theBrutzler/ILI9341_DMG_01/README.md

# ILI9341_DMG_01
 GESP Mainboard for ORIGINAL GAMEBOY
