theBrutzler/ILI9341_DMG_01/ILI9341_ESP32/production/bom.csv

Designator | Footprint | Quantity | Value | LCSC Part #
CN1 | AUDIO-TH_PJ-3043-B | 1 | PJ-3043-B
SM3 | Symbol_kurzschlussblog | 1 | SYM_Arrow45_Tiny
