theBrutzler/ILI9341_DMG_01/ILI9341_ESP32/ILI9341_ESP32.pdf

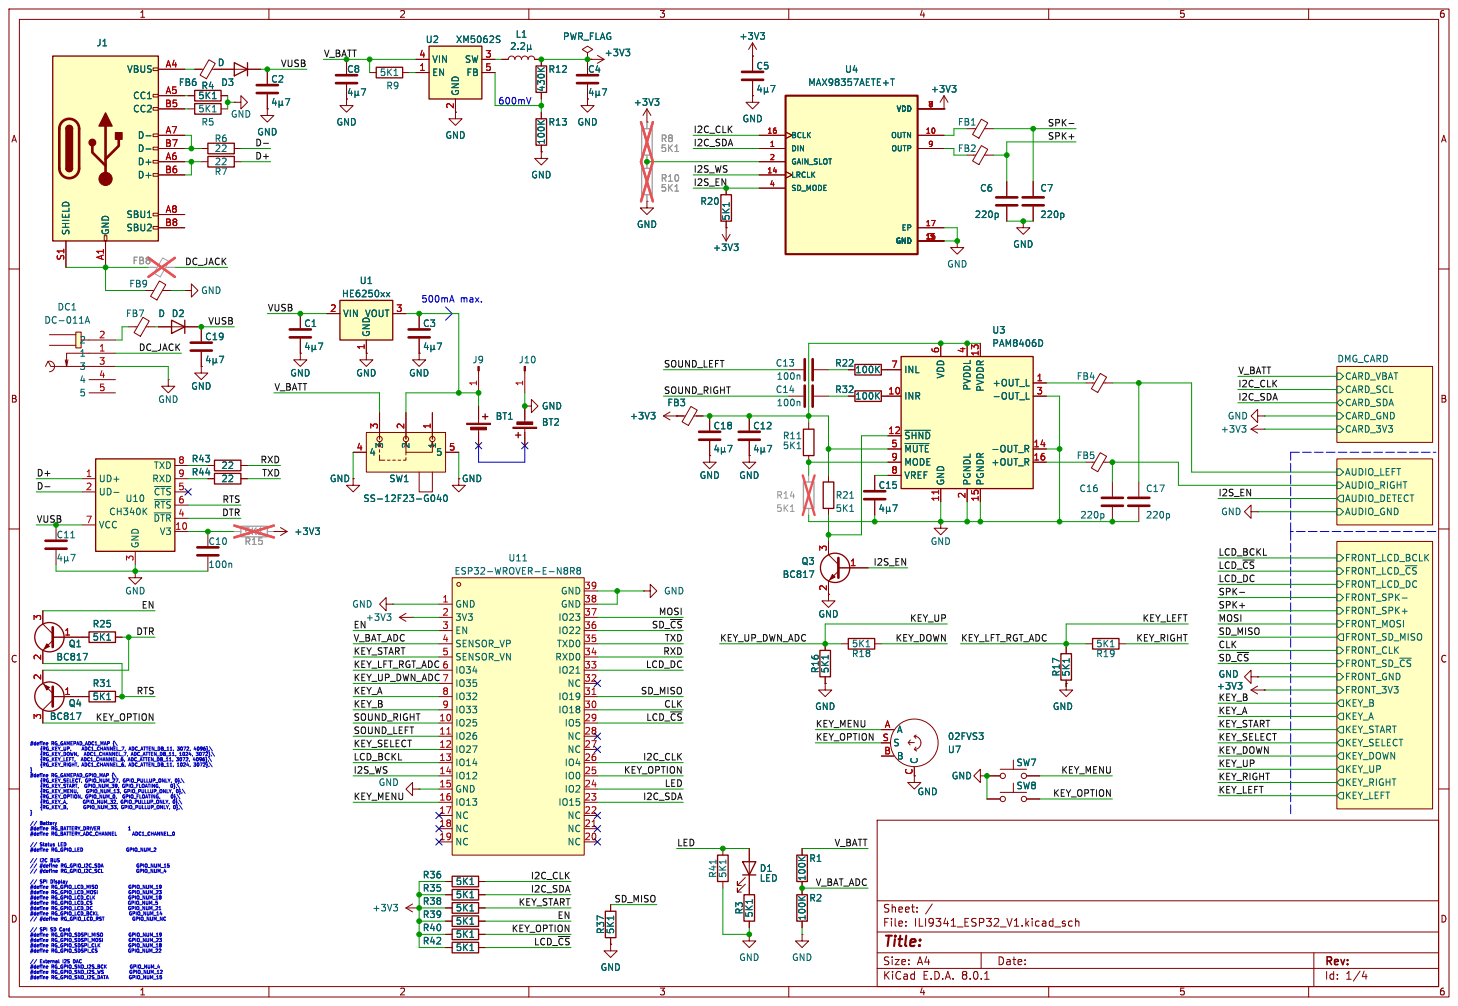
[picture p1: page 1]

2 SW 3 VIN 4 FB 5 GND
220p GND

3 ~{DTR}4 ~{CTS}5 ~{RTS}6 VCC 7 TXD 8 RXD 9 U10 CH340K C19

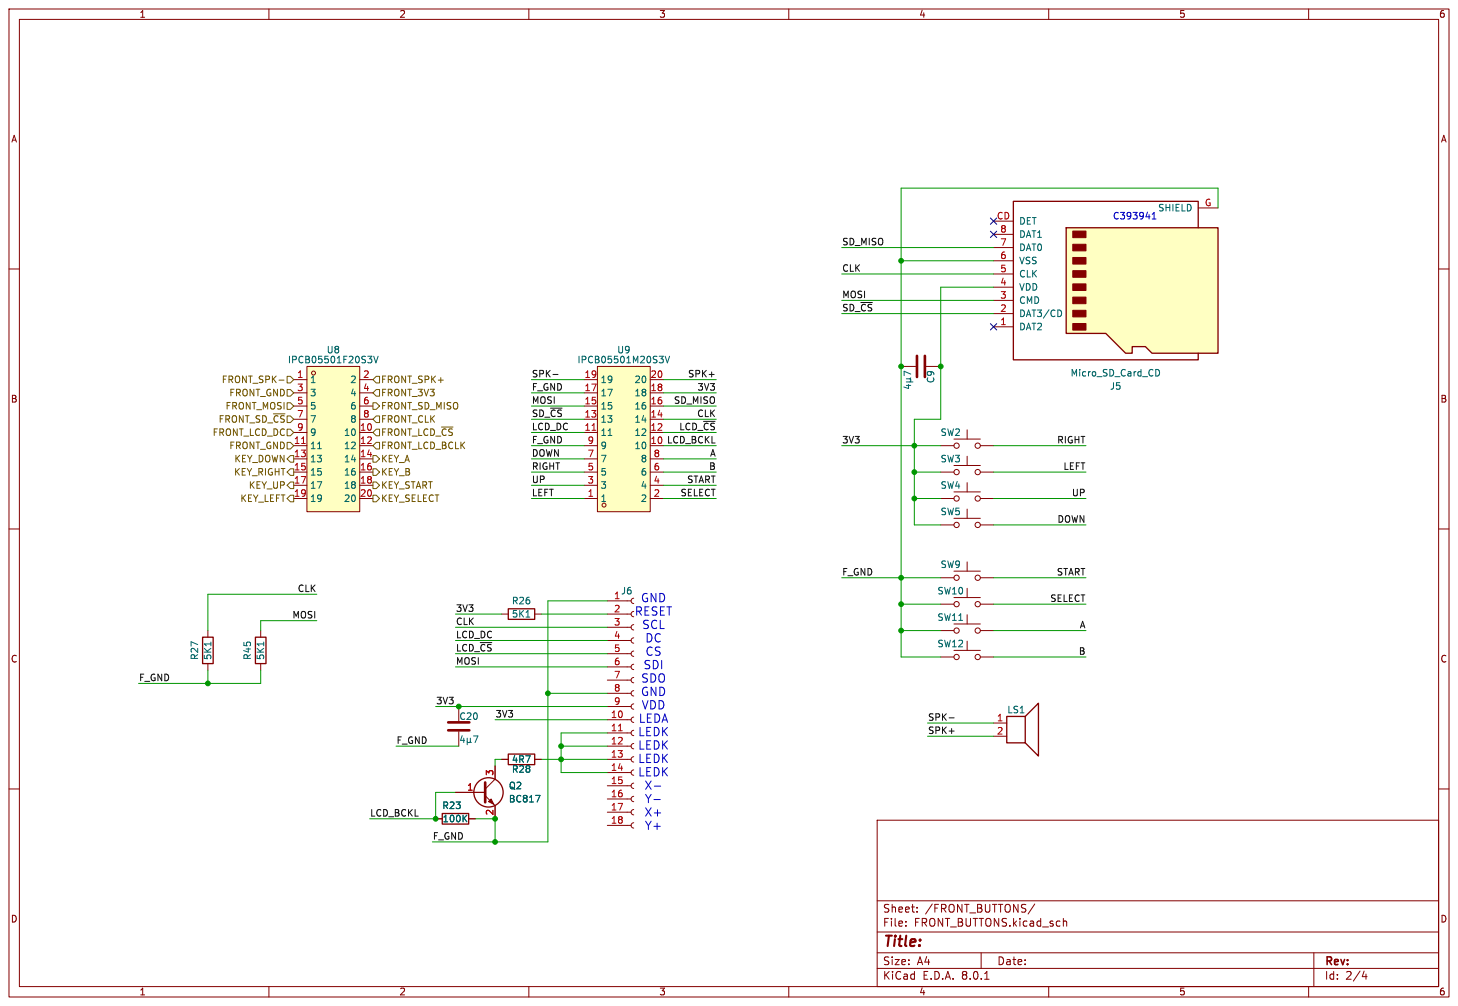
[picture p2: page 2]

LCD_~{CS} MOSI MOSI CLK

Id: 2/4 Title: File: FRONT_BUTTONS.kicad_sch Sheet: /FRONT_BUTTONS/

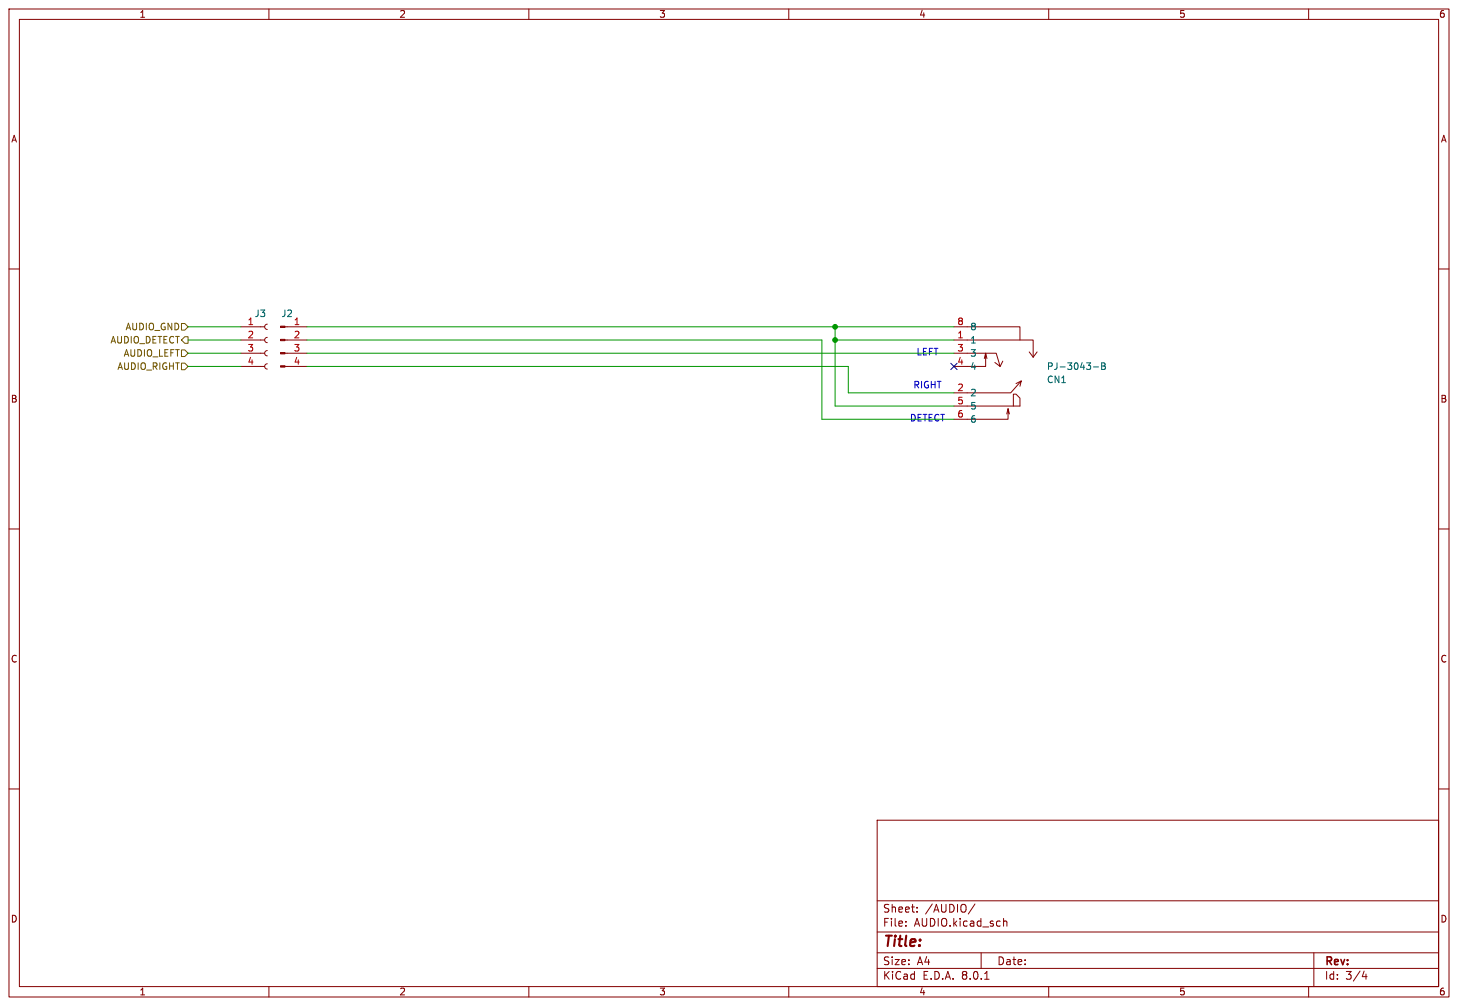
[picture p3: page 3]

Id: 3/4 Title: File: AUDIO.kicad_sch Sheet: /AUDIO/

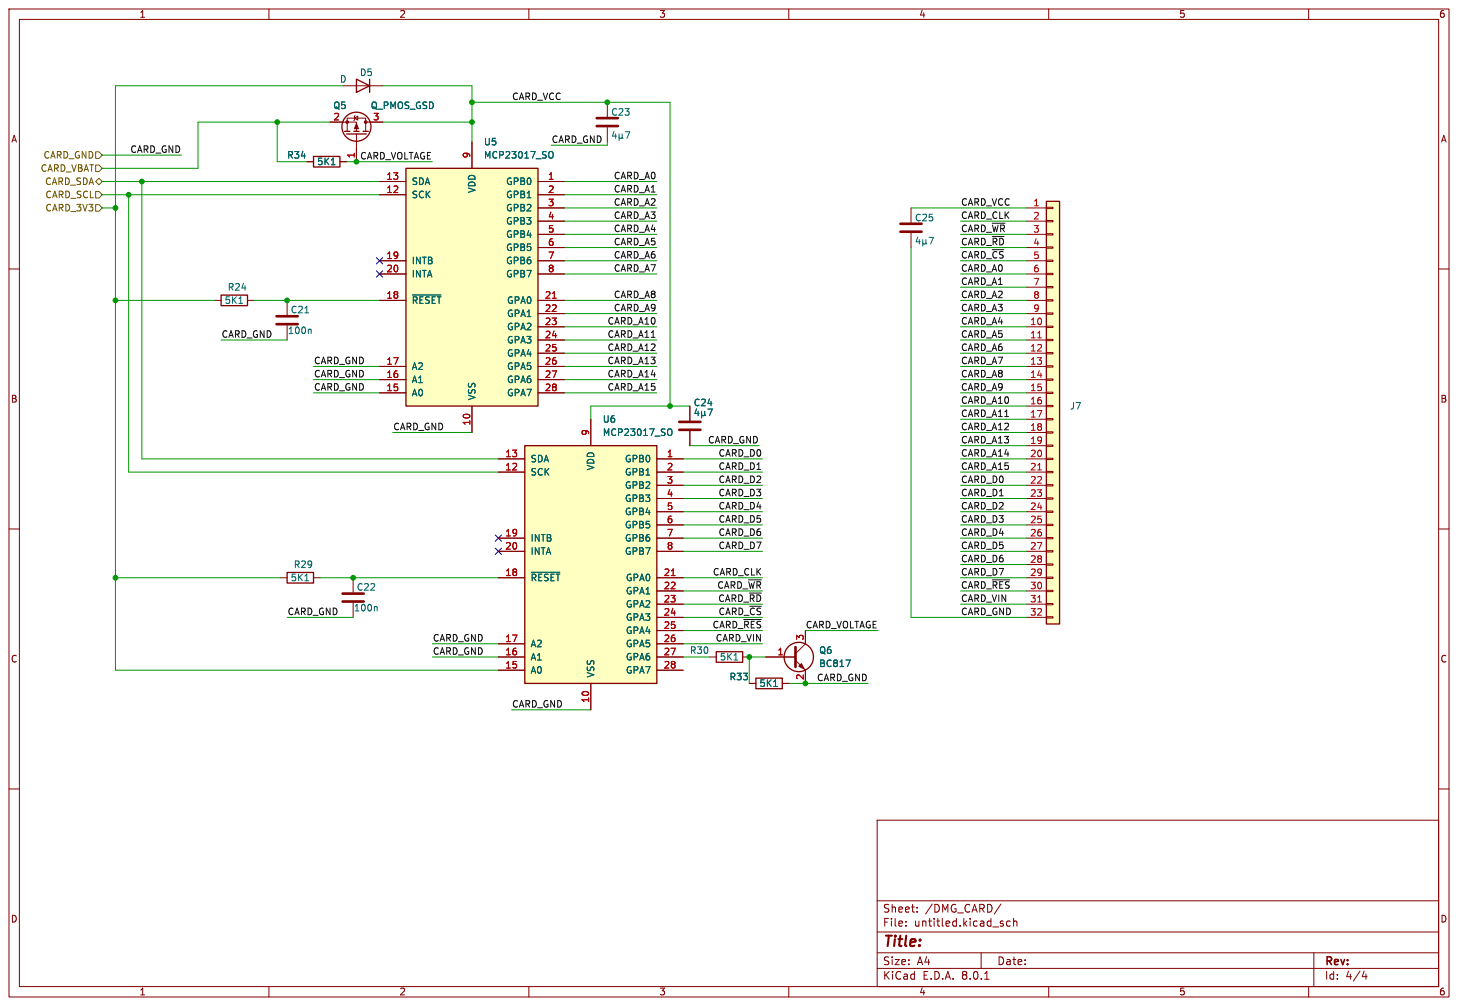
[picture p4: page 4]
