theBrutzler/ILI9341_DMG_01/ILI9341_ESP32/ILI9341_ESP32_PANEL.kicad_pcb

## KiCad design ILI9341_ESP32/ILI9341_ESP32_PANEL.kicad_pcb (2024-07-02)

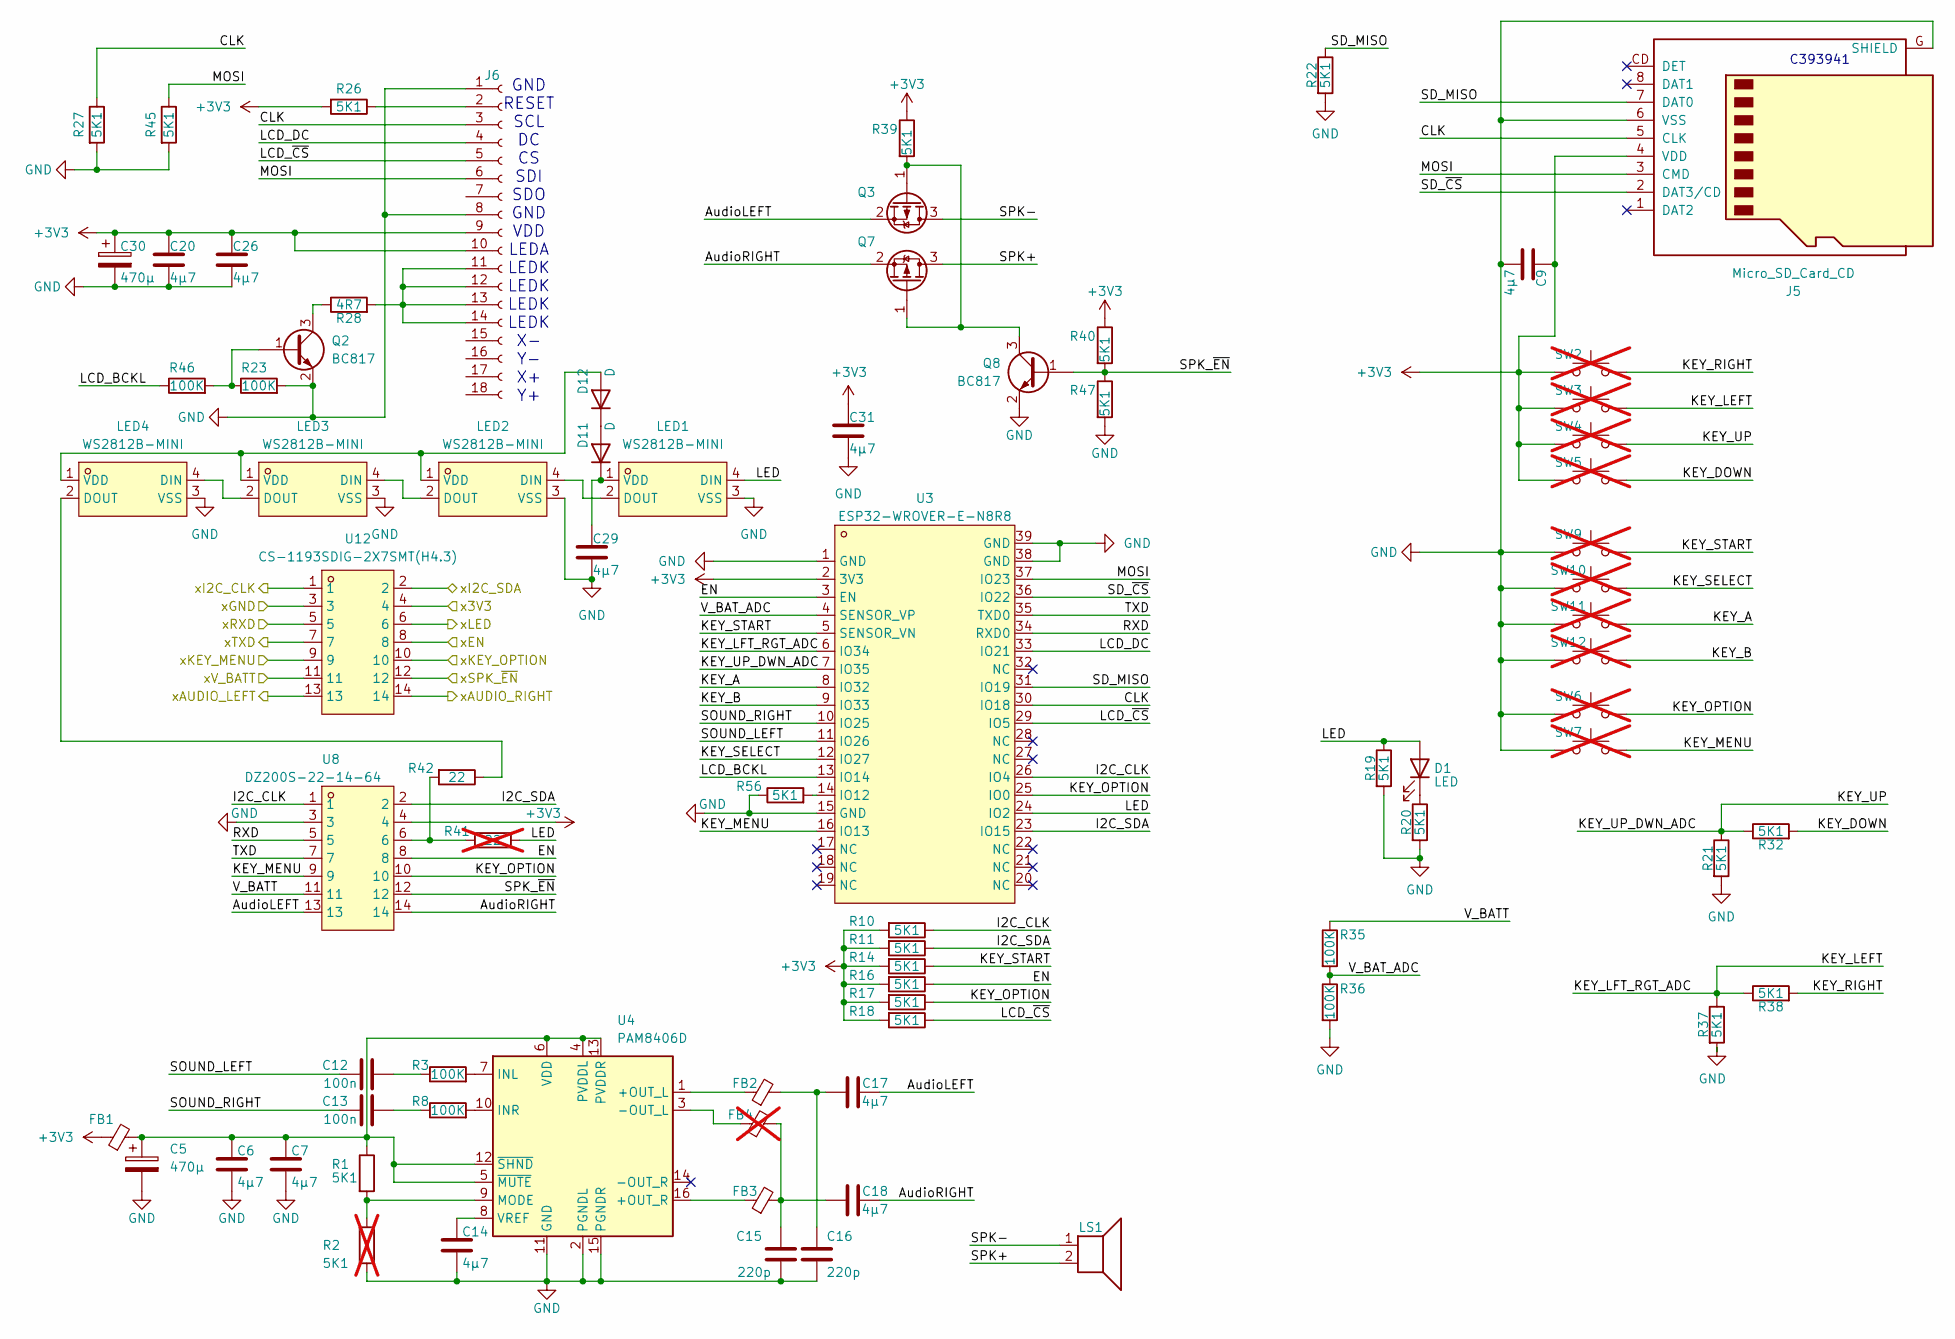
[picture p5: schematic FRONT_BUTTONS.kicad_sch]

Parts:
C5, C30: 470µ; CP_EIA-7343-43_Kemet-X; LCSC C724264
C6, C7, C9, C14, C17, C18, C20, C26, C29, C31: 4µ7; C_1206_3216Metric; LCSC C282809
C12, C13: 100n; C_0603_1608Metric
C15, C16: 220p; C_0603_1608Metric; LCSC C107081
D1: LED; LED_0603_1608Metric
D11, D12: D; Nexperia_CFP3_SOD-123W; LCSC C5120763
FB1, FB2, FB3: FerriteBead_Small; L_0805_2012Metric; LCSC C963878
FB4: FerriteBead_Small; L_0805_2012Metric; LCSC C963878; not fitted
J5: Micro_SD_Card_CD; MicroSD_Self_ bomb; LCSC C393941
J6: Conn_01x18_Socket; solder connector 0.8mm 18 pin
LED1, LED2, LED3, LED4: WS2812B-MINI; LED-SMD_4P-L3.5-W3.5-TL_WS2812B; LCSC C527089
LS1: Speaker; PinHeader_1x02_P2.54mm_Vertical; LCSC C391015
Q2, Q8: BC817; SOT-323_SC-70; LCSC C383187
Q3, Q7: PMOS; SOT-323_SC-70; LCSC C19078062
R1, R10, R11, R14, R16, R17, R18, R19, R20, R21, R22, R26, R27, R32, R37, R38, R39, R40, R45, R47, R56: 5K1; R_0603_1608Metric; LCSC C26000
R2: 5K1; R_0603_1608Metric; LCSC C26000; not fitted
R3, R8, R23, R35, R36, R46: 100K; R_0603_1608Metric; LCSC C15458
R28: 4R7; R_0603_1608Metric; LCSC C491192
R41: 22; R_0603_1608Metric; LCSC C1203; not fitted
R42: 22; R_0603_1608Metric; LCSC C1203
SW2, SW3, SW4, SW5, SW6, SW7, SW9, SW10, SW11, SW12: SW_Push; RubberpadButton_250µ_250µ; not fitted
U3: ESP32-WROVER-E-N8R8; WIFI-SMD_ESP32-WROVER-IE8MB; LCSC C2973667
U4: PAM8406D; SOP-16_3.9x9.9mm_P1.27mm; LCSC C86270
U8: DZ200S-22-14-64; HDR-SMD_14P-P2.00-V-M-R2-C7-LS6.4; LCSC C5160772
U12: CS-1193SDIG-2X7SMT(H4.3); PM200-2-07-S-4.3; LCSC C3975171

Connections:
+3V3: C9.1, C20.1, C26.1, C30.1, C31.1, FB1.1, J5.4 (VDD), J6.9, J6.10, R10.2, R11.2, R14.2, R16.2, R17.2, R18.2, R26.2, R39.1, R40.1, SW2.1, SW3.1, SW4.1, SW5.1, U3.2 (3V3), U8.4
/FRONT_BUTTONS/AudioLEFT: C17.2, Q3.2 (S), U8.13
/FRONT_BUTTONS/AudioRIGHT: C18.2, Q7.2 (S), U8.14
/FRONT_BUTTONS/CLK: J5.5 (CLK), J6.3, R27.1, U3.30 (IO18)
/FRONT_BUTTONS/EN: R16.1, U3.3 (EN), U8.8
/FRONT_BUTTONS/I2C_CLK: R10.1, U3.26 (IO4), U8.1
/FRONT_BUTTONS/I2C_SDA: R11.1, U3.23 (IO15), U8.2
/FRONT_BUTTONS/KEY_A: SW11.2, U3.8 (IO32)
/FRONT_BUTTONS/KEY_B: SW12.2, U3.9 (IO33)
/FRONT_BUTTONS/KEY_DOWN: R32.2, SW5.2
/FRONT_BUTTONS/KEY_LEFT: R37.1, R38.1, SW3.2, U3.6 (IO34)
/FRONT_BUTTONS/KEY_MENU: SW7.2, U3.16 (IO13), U8.9
/FRONT_BUTTONS/KEY_OPTION: R17.1, SW6.2, U3.25 (IO0), U8.10
/FRONT_BUTTONS/KEY_RIGHT: R38.2, SW2.2
/FRONT_BUTTONS/KEY_SELECT: SW10.2, U3.12 (IO27)
/FRONT_BUTTONS/KEY_START: R14.1, SW9.2, U3.5 (SENSOR_VN)
/FRONT_BUTTONS/KEY_UP: R21.1, R32.1, SW4.2, U3.7 (IO35)
/FRONT_BUTTONS/LCD_BCKL: R46.1, U3.13 (IO14)
/FRONT_BUTTONS/LCD_DC: J6.4, U3.33 (IO21)
/FRONT_BUTTONS/LCD_~CS: J6.5, R18.1, U3.29 (IO5)
/FRONT_BUTTONS/LED: D1.2 (A), LED1.4 (DIN), R19.1, R41.1, U3.24 (IO2)
/FRONT_BUTTONS/MOSI: J5.3 (CMD), J6.6, R45.1, U3.37 (IO23)
/FRONT_BUTTONS/RXD: U3.34 (RXD0), U8.5
/FRONT_BUTTONS/SD_MISO: J5.7 (DAT0), R22.1, U3.31 (IO19)
/FRONT_BUTTONS/SD_~CS: J5.2 (DAT3/CD), U3.36 (IO22)
/FRONT_BUTTONS/SOUND_LEFT: C12.1, U3.11 (IO26)
/FRONT_BUTTONS/SOUND_RIGHT: C13.1, U3.10 (IO25)
/FRONT_BUTTONS/SPK+: LS1.2, Q7.3 (D)
/FRONT_BUTTONS/SPK-: LS1.1, Q3.3 (D)
/FRONT_BUTTONS/SPK_~EN: Q8.1 (B), R40.2, R47.1, U8.12
/FRONT_BUTTONS/TXD: U3.35 (TXD0), U8.7
/FRONT_BUTTONS/V_BATT: R35.1, U8.11
/FRONT_BUTTONS/V_BAT_ADC: R35.2, R36.1, U3.4 (SENSOR_VP)
GND: C5.2, C6.2, C7.2, C9.2, C14.2, C15.2, C16.1, C20.2, C26.2, C29.2, C30.2, C31.2, J5.6 (VSS), J5.G (SHIELD), J6.1, J6.8, LED1.3 (VSS), LED2.3 (VSS), LED3.3 (VSS), LED4.3 (VSS), Q2.2 (E), Q8.2 (E), R2.2, R19.2, R20.2, R21.2, R22.2, R23.2, R27.2, R36.2, R37.2, R45.2, R47.2, R56.1, SW6.1, SW7.1, SW9.1, SW10.1, SW11.1, SW12.1, U3.1 (GND), U3.15 (GND), U3.38 (GND), U3.39 (GND), U4.2 (PGNDL), U4.11 (GND), U4.15 (PGNDR), U8.3
unnamed: C12.2, R3.1
unnamed: C13.2, R8.1
unnamed: C15.1, C18.1, FB3.2, FB4.2
unnamed: C16.2, C17.1, FB2.2
unnamed: D1.1 (K), R20.1
unnamed: D11.2 (A), D12.1 (K)
unnamed: C29.1, D11.1 (K), LED1.1 (VDD)
unnamed: D12.2 (A), LED2.1 (VDD), LED3.1 (VDD), LED4.1 (VDD)
unnamed: J6.2, R26.1
unnamed: J6.11, J6.12, J6.13, J6.14, R28.2
unnamed: LED1.2 (DOUT), LED2.4 (DIN)
unnamed: LED2.2 (DOUT), LED3.4 (DIN)
unnamed: LED3.2 (DOUT), LED4.4 (DIN)
unnamed: LED4.2 (DOUT), R42.1
unnamed: Q2.1 (B), R23.1, R46.2
unnamed: Q2.3 (C), R28.1
unnamed: Q3.1 (G), Q7.1 (G), Q8.3 (C), R39.2
unnamed: R41.2, R42.2, U8.6
unnamed: R56.2, U3.14 (IO12)
unnamed: FB2.1, U4.1 (+OUT_L)
unnamed: FB3.1, U4.16 (+OUT_R)
unnamed: FB4.1, U4.3 (-OUT_L)
unnamed: R3.2, U4.7 (INL)
unnamed: R8.2, U4.10 (INR)
unnamed: R1.2, R2.1, U4.9 (MODE)
unnamed: C5.1, C6.1, C7.1, FB1.2, R1.1, U4.4 (PVDDL), U4.5 (~MUTE), U4.6 (VDD), U4.12 (~SHND), U4.13 (PVDDR)
unnamed: C14.1, U4.8 (VREF)

Notes on the sheet:
GND RESET SCL DC CS SDI SDO GND VDD LEDA LEDK LEDK LEDK LEDK X- Y- X+ Y+
C393941

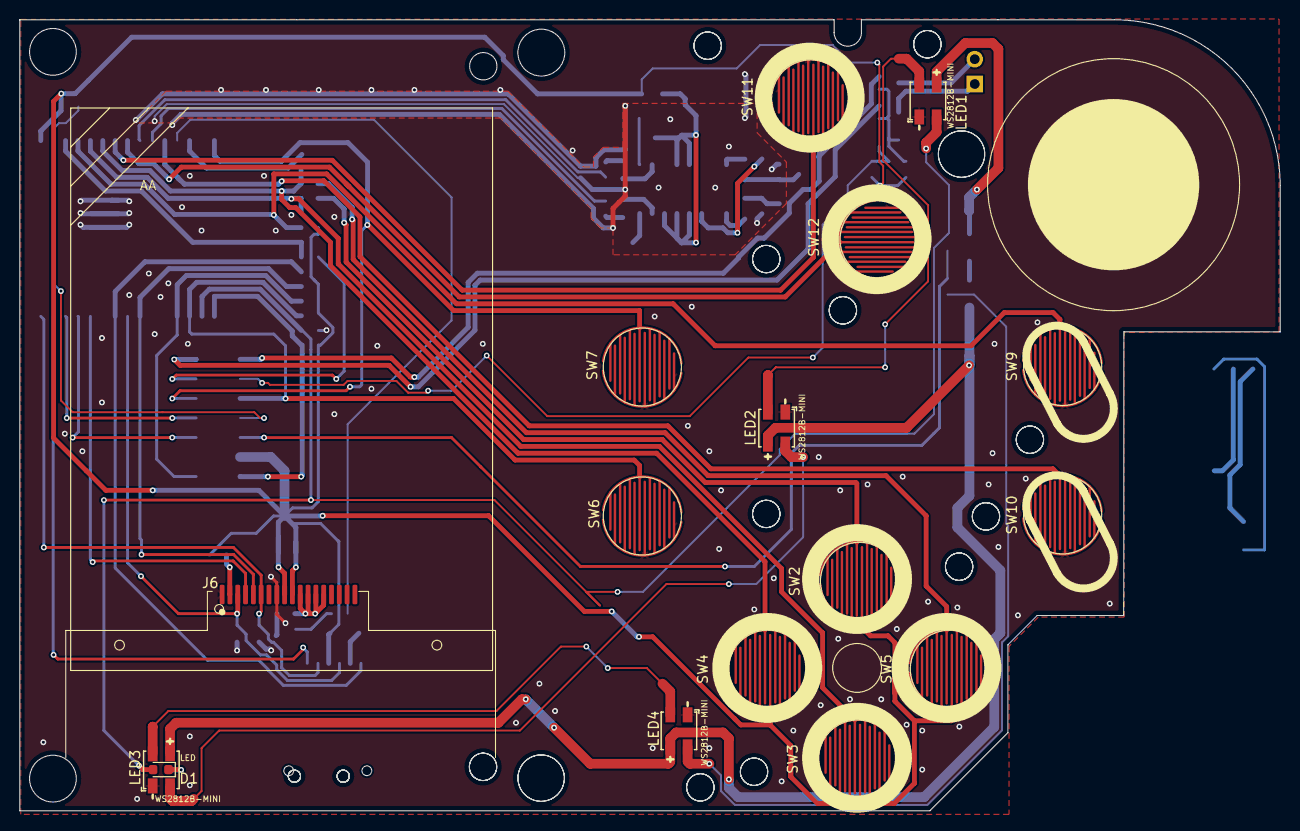
[picture p6: board ILI9341_ESP32_PANEL.kicad_pcb from above]

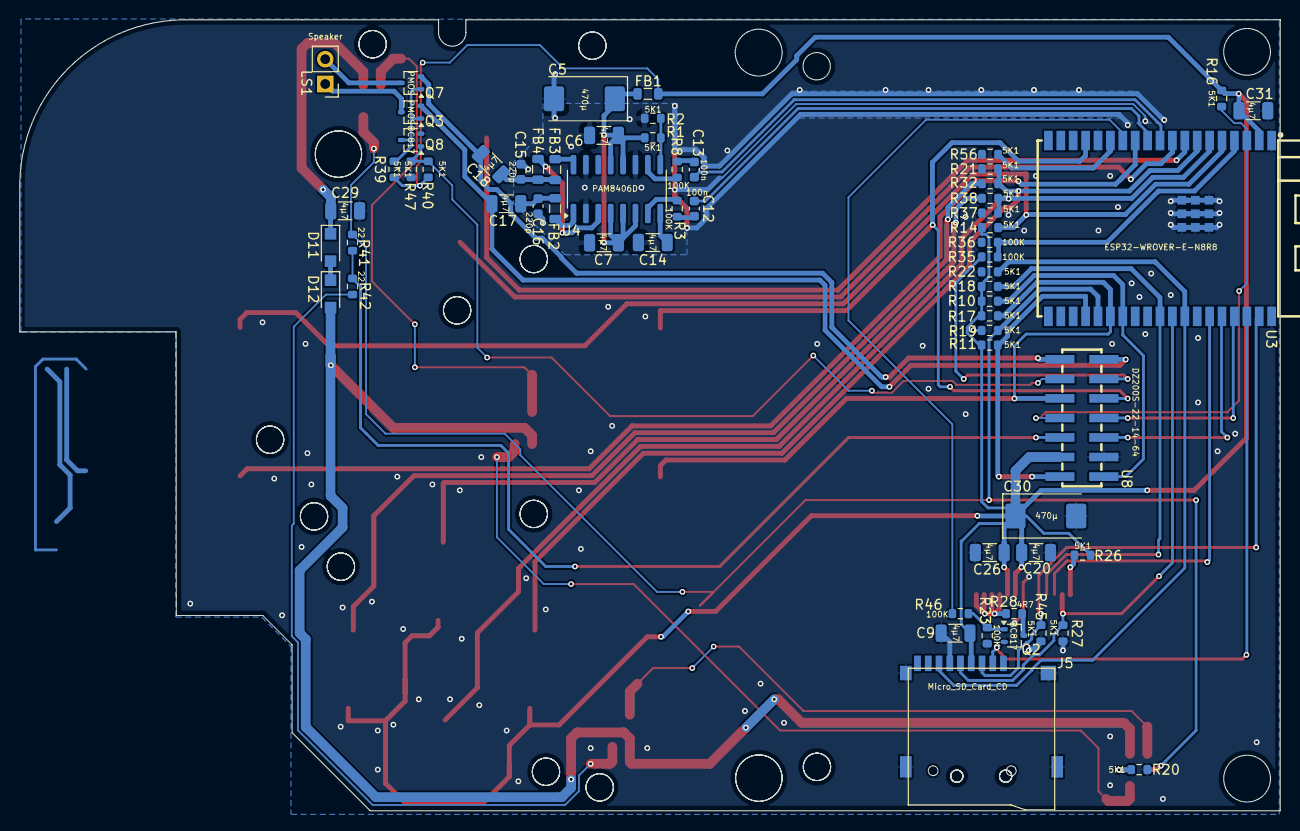
[picture p7: board ILI9341_ESP32_PANEL.kicad_pcb from below]

Board: 2 copper layers, 129.1 x 81.0 mm, 78 parts (62 on the bottom side), 61 nets.
