theBrutzler/ILI9341_DMG_01/ILI9341_ESP32/ILI9341_ESP32_CARD.kicad_pcb

## KiCad design ILI9341_ESP32/ILI9341_ESP32_CARD.kicad_pcb (2024-07-02)

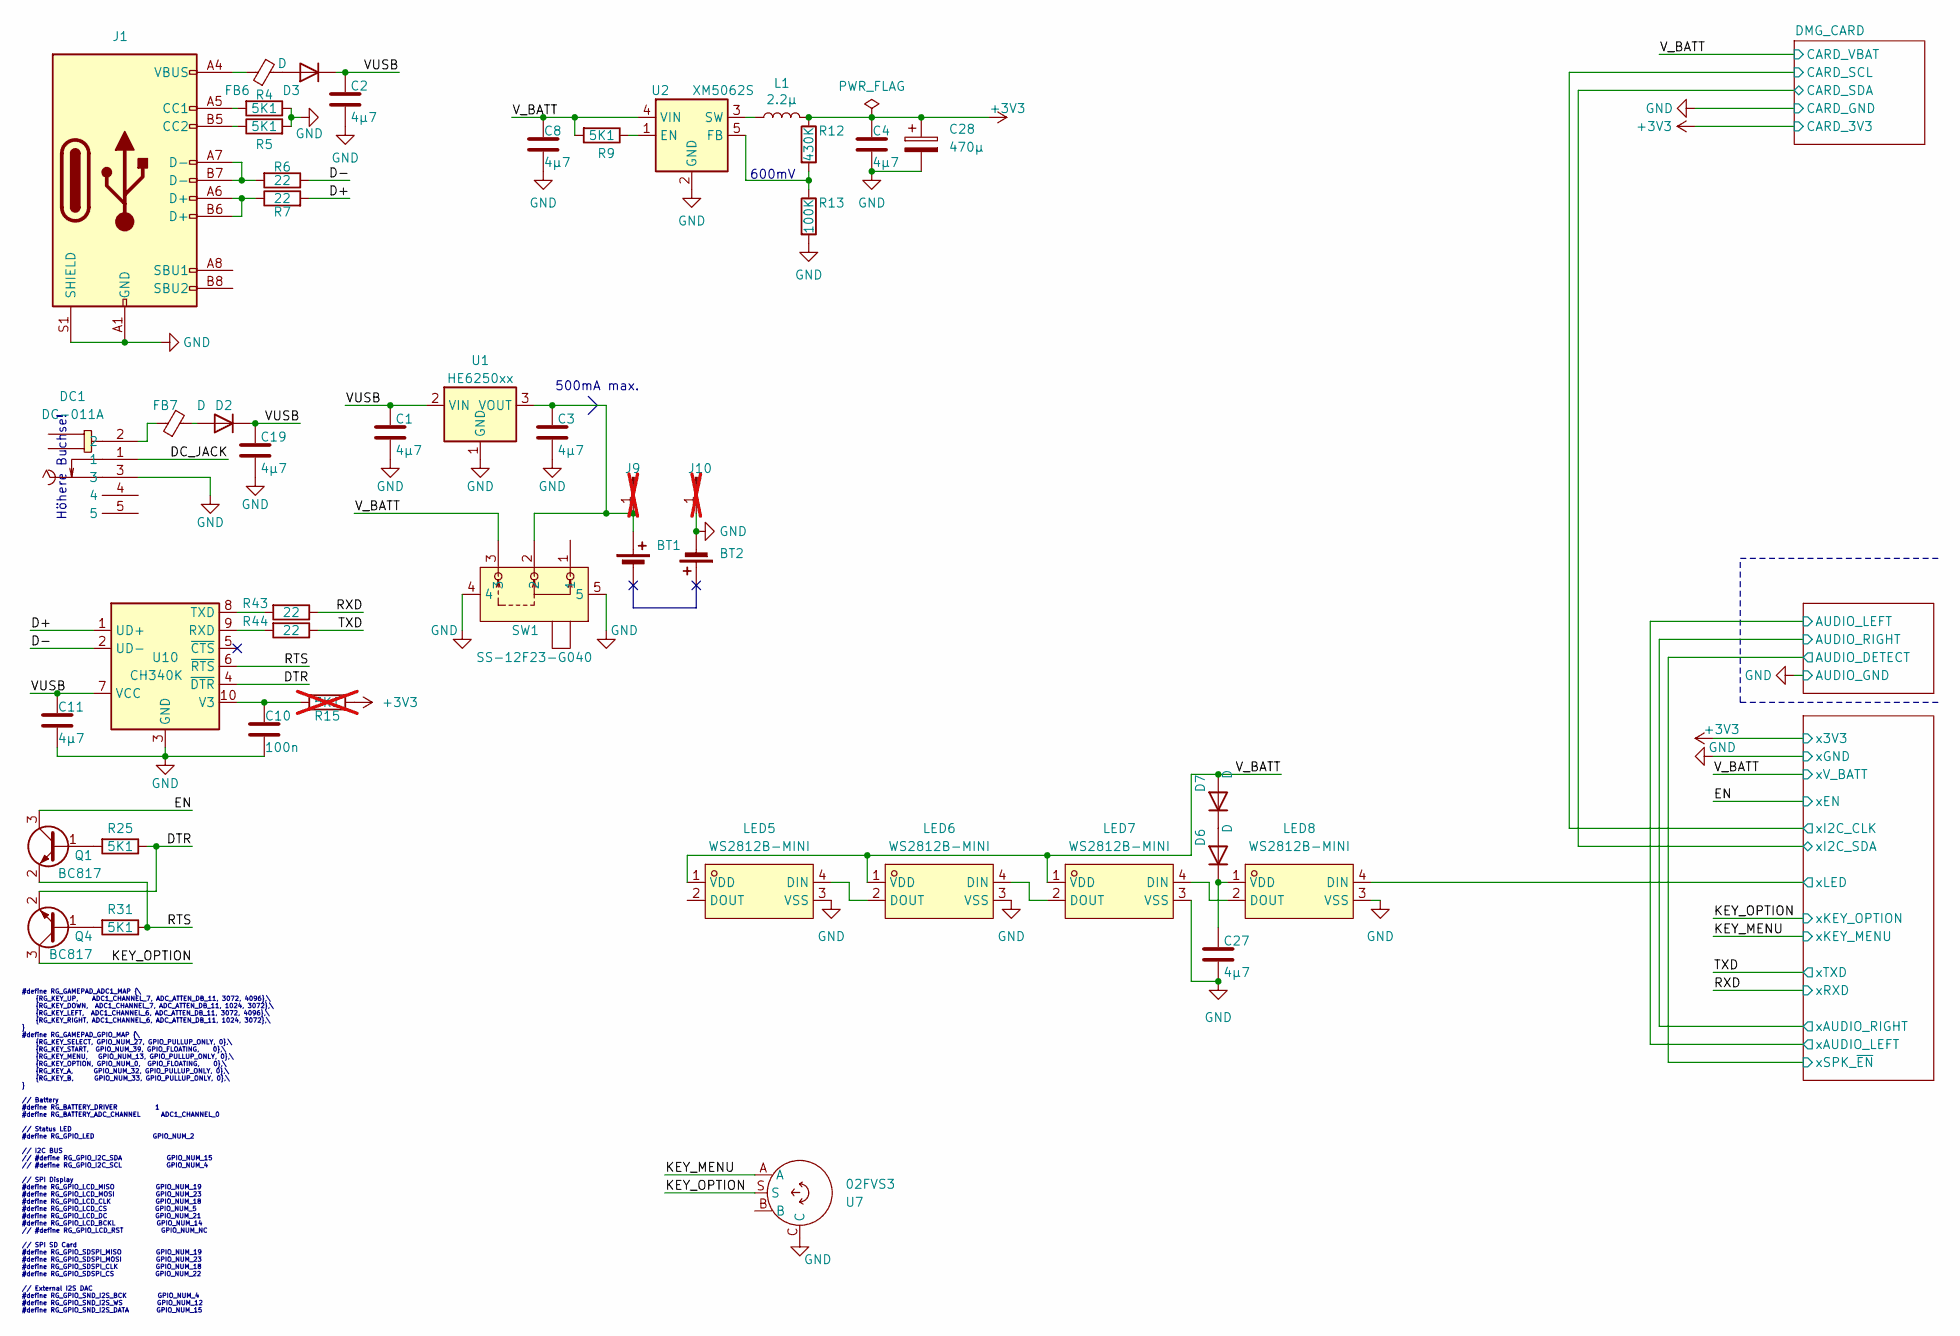
[picture p8: schematic ILI9341_ESP32 - Kopie.kicad_sch]

Parts:
BT1: Battery_Cell; BATTERY_AA_SMD_PLUS; LCSC C964874
BT2: Battery_Cell; BATTERY_AA_SMD_MINUS; LCSC C964876
C1, C2, C3, C4, C8, C11, C19, C27: 4µ7; C_1206_3216Metric; LCSC C282809
C10: 100n; C_0603_1608Metric
C28: 470µ; CP_EIA-7343-43_Kemet-X; LCSC C724264
D2, D3, D6, D7: D; Nexperia_CFP3_SOD-123W; LCSC C5120763
DC1: DC-011A; DC-IN-TH_DC-011A; LCSC C480366
FB6, FB7: FerriteBead_Small; L_0805_2012Metric; LCSC C963878
J1: USB_C_Receptacle_USB2.0_16P; USB_C_Receptacle_HRO_TYPE-C-31-M-12; LCSC C165948
J9: Conn_01x01_Pin; NINTENDO_PLUS; not fitted
J10: Conn_01x01_Pin; NINTENDO_MINUS; not fitted
L1: 2.2µ; L_1210_3225Metric_Pad1.42x2.65mm_HandSolder; LCSC C3002559
LED5, LED6, LED7, LED8: WS2812B-MINI; LED-SMD_4P-L3.5-W3.5-TL_WS2812B; LCSC C527089
Q1, Q4: BC817; SOT-323_SC-70; LCSC C383187
R4, R5, R9, R25, R31: 5K1; R_0603_1608Metric_Pad0.98x0.95mm_HandSolder; LCSC C26000
R6, R7, R43, R44: 22; R_0603_1608Metric_Pad0.98x0.95mm_HandSolder; LCSC C1203
R12: 430K; R_0603_1608Metric_Pad0.98x0.95mm_HandSolder; LCSC C25969
R13: 100K; R_0603_1608Metric_Pad0.98x0.95mm_HandSolder; LCSC C15458
R15: 5K1; R_0603_1608Metric_Pad0.98x0.95mm_HandSolder; LCSC C26000; not fitted
SW1: SS-12F23-G040; SW-TH_SS-12F23-G040; LCSC C2848932
U1: HE6250xx; SOT-89-3; LCSC C711940
U2: XM5062S; SOT-23-5; LCSC C2924930
U7: 02FVS3; LCSC C2925423
U10: CH340K; SSOP-10_3.9x4.9mm_P1.00mm_EP_3mmx2mm; LCSC C968586

Connections:
+3V3: C4.1, C28.1, L1.2, R12.1, R15.2; also elsewhere on the board
/D+: R7.2, U10.1 (UD+)
/D-: R6.1, U10.2 (UD-)
/DC_JACK: DC1.1
/DTR: Q4.2 (E), R25.1, U10.4 (~DTR)
/EN: Q1.3 (C); also elsewhere on the board
/FRONT_BUTTONS/xLED: LED8.4 (DIN); also elsewhere on the board
/KEY_MENU: U7.A; also elsewhere on the board
/KEY_OPTION: Q4.3 (C), U7.S; also elsewhere on the board
/RTS: Q1.2 (E), R31.1, U10.6 (~RTS)
/RXD: R43.1; also elsewhere on the board
/TXD: R44.1; also elsewhere on the board
unnamed: D2.2 (A), FB7.2
unnamed: D3.2 (A), FB6.2
unnamed: D6.2 (A), D7.1 (K)
unnamed: C27.1, D6.1 (K), LED8.1 (VDD)
unnamed: DC1.2, FB7.1
unnamed: FB6.1, J1.A4 (VBUS), J1.A9 (VBUS), J1.B4 (VBUS), J1.B9 (VBUS)
unnamed: J1.A5 (CC1), R4.2
unnamed: J1.B5 (CC2), R5.1
unnamed: J1.A6 (D+), J1.B6 (D+), R7.1
unnamed: J1.A7 (D-), J1.B7 (D-), R6.2
unnamed: LED5.4 (DIN), LED6.2 (DOUT)
unnamed: LED6.4 (DIN), LED7.2 (DOUT)
unnamed: LED7.4 (DIN), LED8.2 (DOUT)
unnamed: Q1.1 (B), R25.2
unnamed: Q4.1 (B), R31.2
unnamed: R12.2, R13.1, U2.5 (FB)
unnamed: L1.1, U2.3 (SW)
unnamed: R44.2, U10.9 (RXD)
unnamed: R43.2, U10.8 (TXD)
unnamed: C10.1, R15.1, U10.10 (V3)

Notes on the sheet:
600mV
#define RG_GAMEPAD_ADC1_MAP {\ {RG_KEY_UP, ADC1_CHANNEL_7, ADC_ATTEN_DB_11, 3072, 4096},\ {RG_KEY_DOWN, ADC1_CHANNEL_7, ADC_ATTEN_DB_11, 1024, 3072},\ {RG_KEY_LEFT, ADC1_CHANNEL_6, ADC_ATTEN_DB_11, 3072, 4096},\ {RG_KEY_RIGHT, ADC1_CHANNEL_6, ADC_ATTEN_DB_11, 1024, 3072},\ } #define RG_GAMEPAD_GPIO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
500mA max.
Höhere Buchse!

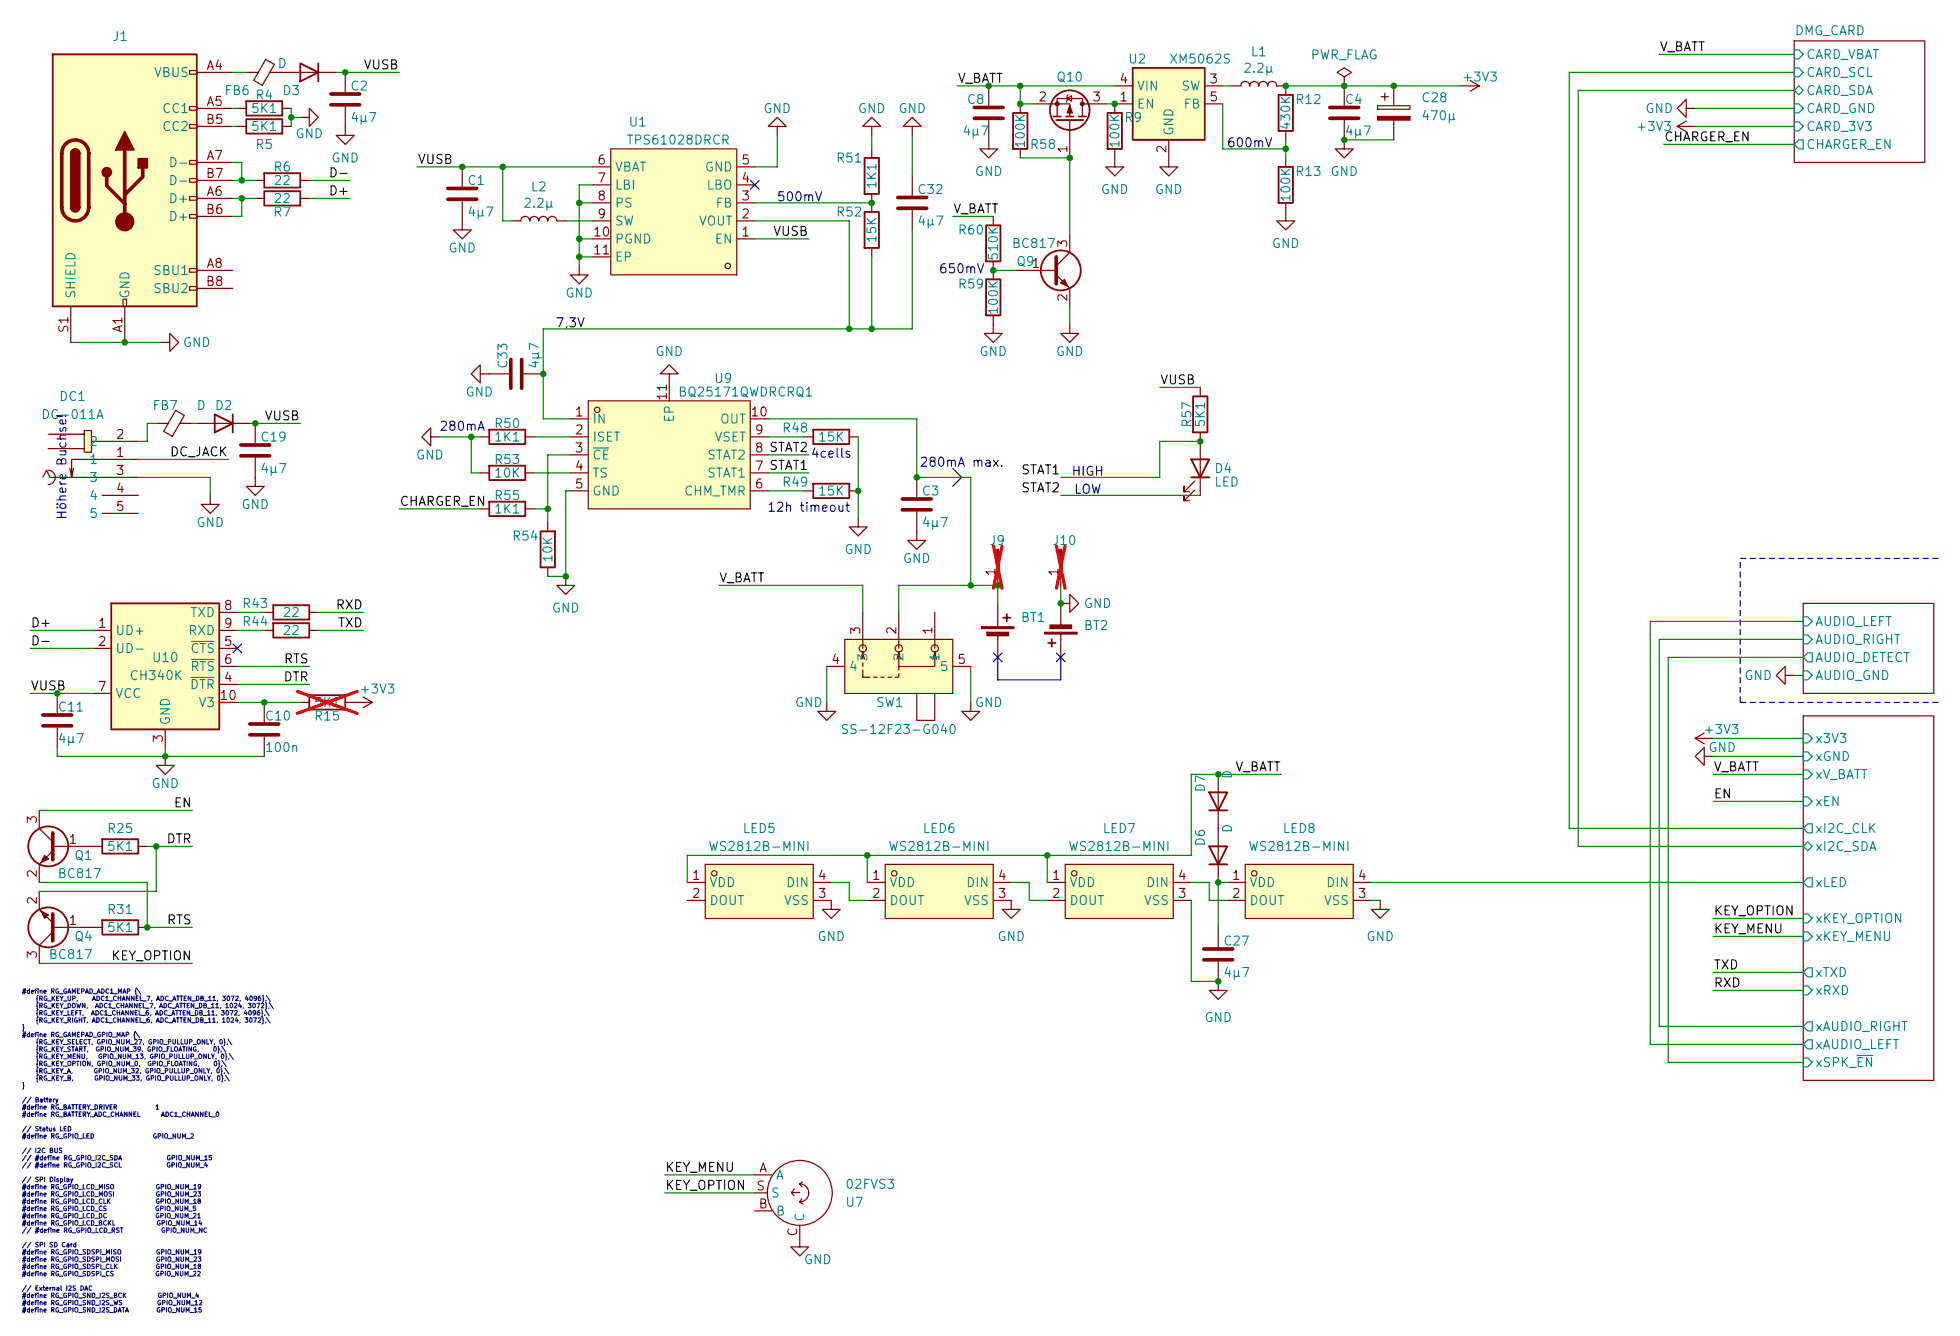
[picture p9: schematic ILI9341_ESP32.kicad_sch]

Parts:
BT1: Battery_Cell; BATTERY_AA_SMD_PLUS; LCSC C964874
BT2: Battery_Cell; BATTERY_AA_SMD_MINUS; LCSC C964876
C1, C2, C3, C4, C8, C11, C19, C27, C32, C33: 4µ7; C_1206_3216Metric; LCSC C282809
C10: 100n; C_0603_1608Metric
C28: 470µ; CP_EIA-7343-43_Kemet-X; LCSC C724264
D2, D3, D6, D7: D; Nexperia_CFP3_SOD-123W; LCSC C5120763
D4: LED; LED_0603_1608Metric
DC1: DC-011A; DC-IN-TH_DC-011A; LCSC C480366
FB6, FB7: FerriteBead_Small; L_0805_2012Metric; LCSC C963878
J1: USB_C_Receptacle_USB2.0_16P; USB_C_Receptacle_HRO_TYPE-C-31-M-12; LCSC C165948
J9: Conn_01x01_Pin; NINTENDO_PLUS; not fitted
J10: Conn_01x01_Pin; NINTENDO_MINUS; not fitted
L1, L2: 2.2µ; L_1210_3225Metric_Pad1.42x2.65mm_HandSolder; LCSC C3002559
LED5, LED6, LED7, LED8: WS2812B-MINI; LED-SMD_4P-L3.5-W3.5-TL_WS2812B; LCSC C527089
Q1, Q4, Q9: BC817; SOT-323_SC-70; LCSC C383187
Q10: PMOS; SOT-323_SC-70; LCSC C19078062
R4, R5, R25, R31, R57: 5K1; R_0603_1608Metric; LCSC C26000
R6, R7, R43, R44: 22; R_0603_1608Metric; LCSC C1203
R9, R13, R58, R59: 100K; R_0603_1608Metric; LCSC C15458
R12: 430K; R_0603_1608Metric; LCSC C25969
R15: 5K1; R_0603_1608Metric; LCSC C26000; not fitted
R48, R49, R52: 15K; R_0603_1608Metric; LCSC C2906995
R50, R51, R55: 1K1; R_0603_1608Metric; LCSC C2906975
R53, R54: 10K; R_0603_1608Metric; LCSC C25804
R60: 510K; R_0603_1608Metric; LCSC C23192
SW1: SS-12F23-G040; SW-TH_SS-12F23-G040; LCSC C2848932
U1: TPS61028DRCR; VSON-10_L3.0-W3.0-P0.50-TL-EP-1; LCSC Part C575574
U2: XM5062S; SOT-23-5; LCSC C2924930
U7: 02FVS3; LCSC C2925423
U9: BQ25171QWDRCRQ1; VSON-10_L3.0-W3.0-P0.50-BL-EP1.65; LCSC C2861221
U10: CH340K; SSOP-10_3.9x4.9mm_P1.00mm_EP_3mmx2mm; LCSC C968586

Connections:
+3V3: C4.1, C28.1, L1.2, R12.1, R15.2; also elsewhere on the board
/CHARGER_EN: R55.2; also elsewhere on the board
/D+: R7.2, U10.1 (UD+)
/D-: R6.1, U10.2 (UD-)
/DC_JACK: DC1.1
/DTR: Q4.2 (E), R25.1, U10.4 (~DTR)
/EN: Q1.3 (C); also elsewhere on the board
/FRONT_BUTTONS/xLED: LED8.4 (DIN); also elsewhere on the board
/KEY_MENU: U7.A; also elsewhere on the board
/KEY_OPTION: Q4.3 (C), U7.S; also elsewhere on the board
/RTS: Q1.2 (E), R31.1, U10.6 (~RTS)
/RXD: R43.1; also elsewhere on the board
/STAT1: D4.2 (A), R57.2, U9.7 (STAT1)
/STAT2: D4.1 (K), U9.8 (STAT2)
/TXD: R44.1; also elsewhere on the board
unnamed: D2.2 (A), FB7.2
unnamed: D3.2 (A), FB6.2
unnamed: D6.2 (A), D7.1 (K)
unnamed: C27.1, D6.1 (K), LED8.1 (VDD)
unnamed: DC1.2, FB7.1
unnamed: FB6.1, J1.A4 (VBUS), J1.A9 (VBUS), J1.B4 (VBUS), J1.B9 (VBUS)
unnamed: J1.A5 (CC1), R4.2
unnamed: J1.B5 (CC2), R5.1
unnamed: J1.A6 (D+), J1.B6 (D+), R7.1
unnamed: J1.A7 (D-), J1.B7 (D-), R6.2
unnamed: LED5.4 (DIN), LED6.2 (DOUT)
unnamed: LED6.4 (DIN), LED7.2 (DOUT)
unnamed: LED7.4 (DIN), LED8.2 (DOUT)
unnamed: Q1.1 (B), R25.2
unnamed: Q4.1 (B), R31.2
unnamed: Q9.1 (B), R59.1, R60.2
unnamed: Q9.3 (C), Q10.1 (G), R58.2
unnamed: L2.2, U1.9 (SW)
unnamed: R12.2, R13.1, U2.5 (FB)
unnamed: L1.1, U2.3 (SW)
unnamed: R49.2, U9.6 (CHM_TMR)
unnamed: R50.1, U9.2 (ISET)
unnamed: R53.1, U9.4 (TS)
unnamed: R48.2, U9.9 (VSET)
unnamed: R54.2, R55.1, U9.3 (~CE)
unnamed: R44.2, U10.9 (RXD)
unnamed: R43.2, U10.8 (TXD)
unnamed: C10.1, R15.1, U10.10 (V3)

Notes on the sheet:
650mV
600mV
280mA
#define RG_GAMEPAD_ADC1_MAP {\ {RG_KEY_UP, ADC1_CHANNEL_7, ADC_ATTEN_DB_11, 3072, 4096},\ {RG_KEY_DOWN, ADC1_CHANNEL_7, ADC_ATTEN_DB_11, 1024, 3072},\ {RG_KEY_LEFT, ADC1_CHANNEL_6, ADC_ATTEN_DB_11, 3072, 4096},\ {RG_KEY_RIGHT, ADC1_CHANNEL_6, ADC_ATTEN_DB_11, 1024, 3072},\ } #define RG_GAMEPAD_GPIO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
280mA max.
500mV
Höhere Buchse!
7,3V
LOW
4cells
12h timeout
HIGH

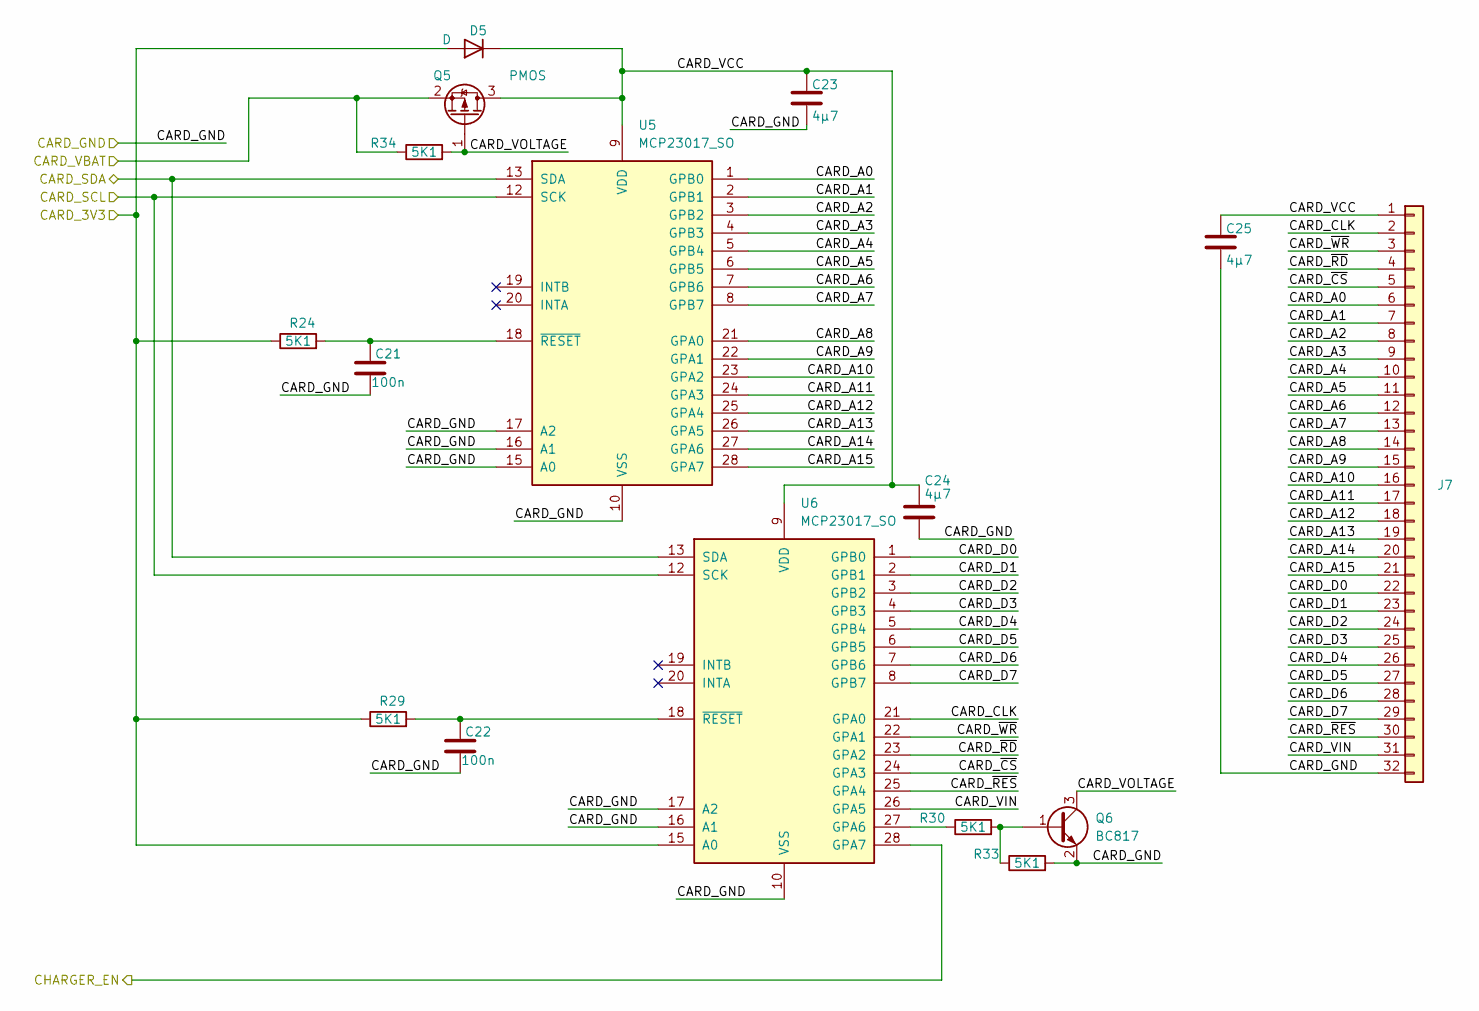
[picture p10: schematic untitled.kicad_sch]

Parts:
C21, C22: 100n; C_0603_1608Metric
C23, C24, C25: 4µ7; C_1206_3216Metric; LCSC C282809
D5: D; Nexperia_CFP3_SOD-123W; LCSC C5120763
J7: Conn_01x32; DMG_01_CARDRIDGE_CONNECTOR
Q5: PMOS; SOT-323_SC-70; LCSC C19078062
Q6: BC817; SOT-323_SC-70; LCSC C383187
R24, R29, R30, R33, R34: 5K1; R_0603_1608Metric; LCSC C26000
U5, U6: MCP23017_SO; SOIC-28W_7.5x17.9mm_P1.27mm; LCSC C47023

Connections:
+3V3: D5.2 (A), R24.1, R29.1, U6.15 (A0); also elsewhere on the board
/CHARGER_EN: U6.28 (GPA7); also elsewhere on the board
/DMG_CARD/CARD_A0: J7.6, U5.1 (GPB0)
/DMG_CARD/CARD_A1: J7.7, U5.2 (GPB1)
/DMG_CARD/CARD_A2: J7.8, U5.3 (GPB2)
/DMG_CARD/CARD_A3: J7.9, U5.4 (GPB3)
/DMG_CARD/CARD_A4: J7.10, U5.5 (GPB4)
/DMG_CARD/CARD_A5: J7.11, U5.6 (GPB5)
/DMG_CARD/CARD_A6: J7.12, U5.7 (GPB6)
/DMG_CARD/CARD_A7: J7.13, U5.8 (GPB7)
/DMG_CARD/CARD_A8: J7.14, U5.21 (GPA0)
/DMG_CARD/CARD_A9: J7.15, U5.22 (GPA1)
/DMG_CARD/CARD_A10: J7.16, U5.23 (GPA2)
/DMG_CARD/CARD_A11: J7.17, U5.24 (GPA3)
/DMG_CARD/CARD_A12: J7.18, U5.25 (GPA4)
/DMG_CARD/CARD_A13: J7.19, U5.26 (GPA5)
/DMG_CARD/CARD_A14: J7.20, U5.27 (GPA6)
/DMG_CARD/CARD_A15: J7.21, U5.28 (GPA7)
/DMG_CARD/CARD_CLK: J7.2, U6.21 (GPA0)
/DMG_CARD/CARD_D0: J7.22, U6.1 (GPB0)
/DMG_CARD/CARD_D1: J7.23, U6.2 (GPB1)
/DMG_CARD/CARD_D2: J7.24, U6.3 (GPB2)
/DMG_CARD/CARD_D3: J7.25, U6.4 (GPB3)
/DMG_CARD/CARD_D4: J7.26, U6.5 (GPB4)
/DMG_CARD/CARD_D5: J7.27, U6.6 (GPB5)
/DMG_CARD/CARD_D6: J7.28, U6.7 (GPB6)
/DMG_CARD/CARD_D7: J7.29, U6.8 (GPB7)
/DMG_CARD/CARD_SCL: U5.12 (SCK), U6.12 (SCK); also elsewhere on the board
/DMG_CARD/CARD_SDA: U5.13 (SDA), U6.13 (SDA); also elsewhere on the board
/DMG_CARD/CARD_VCC: C23.1, C24.1, C25.1, D5.1 (K), J7.1, Q5.3 (D), U5.9 (VDD), U6.9 (VDD)
/DMG_CARD/CARD_VIN: J7.31, U6.26 (GPA5)
/DMG_CARD/CARD_VOLTAGE: Q5.1 (G), Q6.3 (C), R34.2
/DMG_CARD/CARD_~CS: J7.5, U6.24 (GPA3)
/DMG_CARD/CARD_~RD: J7.4, U6.23 (GPA2)
/DMG_CARD/CARD_~RES: J7.30, U6.25 (GPA4)
/DMG_CARD/CARD_~WR: J7.3, U6.22 (GPA1)
unnamed: Q6.1 (B), R30.2, R33.1
unnamed: C21.2, R24.2, U5.18 (~RESET)
unnamed: R30.1, U6.27 (GPA6)
unnamed: C22.2, R29.2, U6.18 (~RESET)

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
