theBrutzler/ILI9341_DMG_01/ILI9341_ESP32/ILI9341_ESP32_CARD.kicad_pcb

## KiCad design ILI9341_ESP32/ILI9341_ESP32_CARD.kicad_pcb (continued)

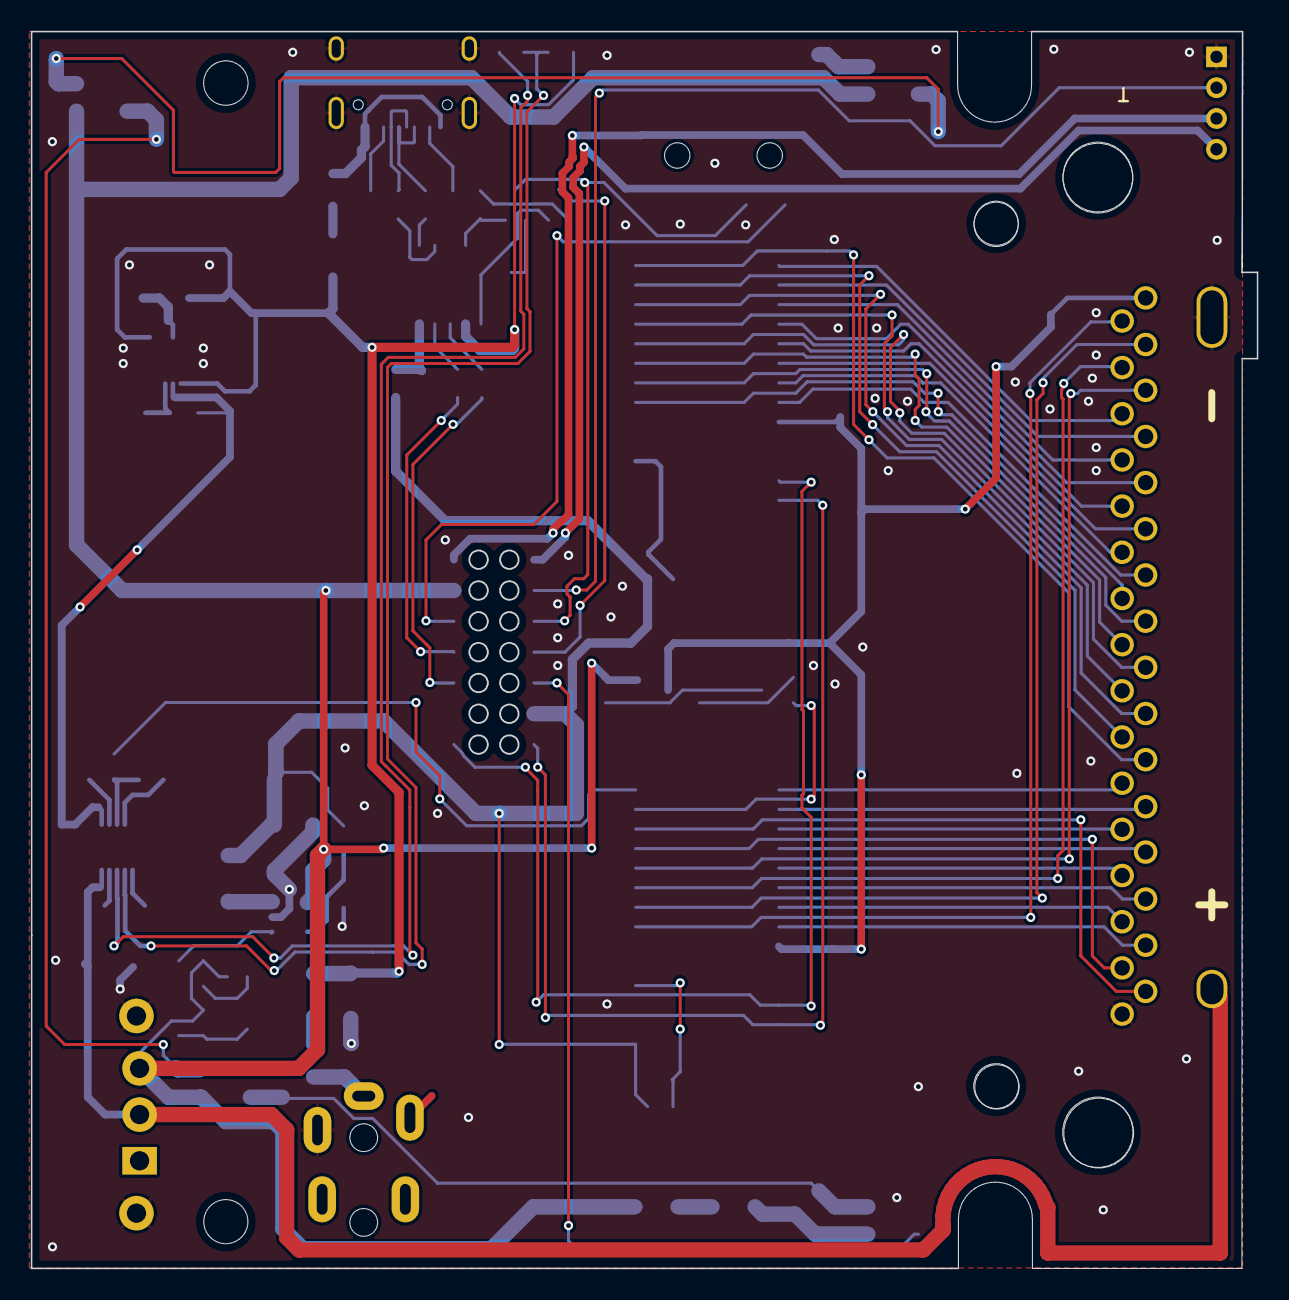
[picture p11: board ILI9341_ESP32_CARD.kicad_pcb from above]

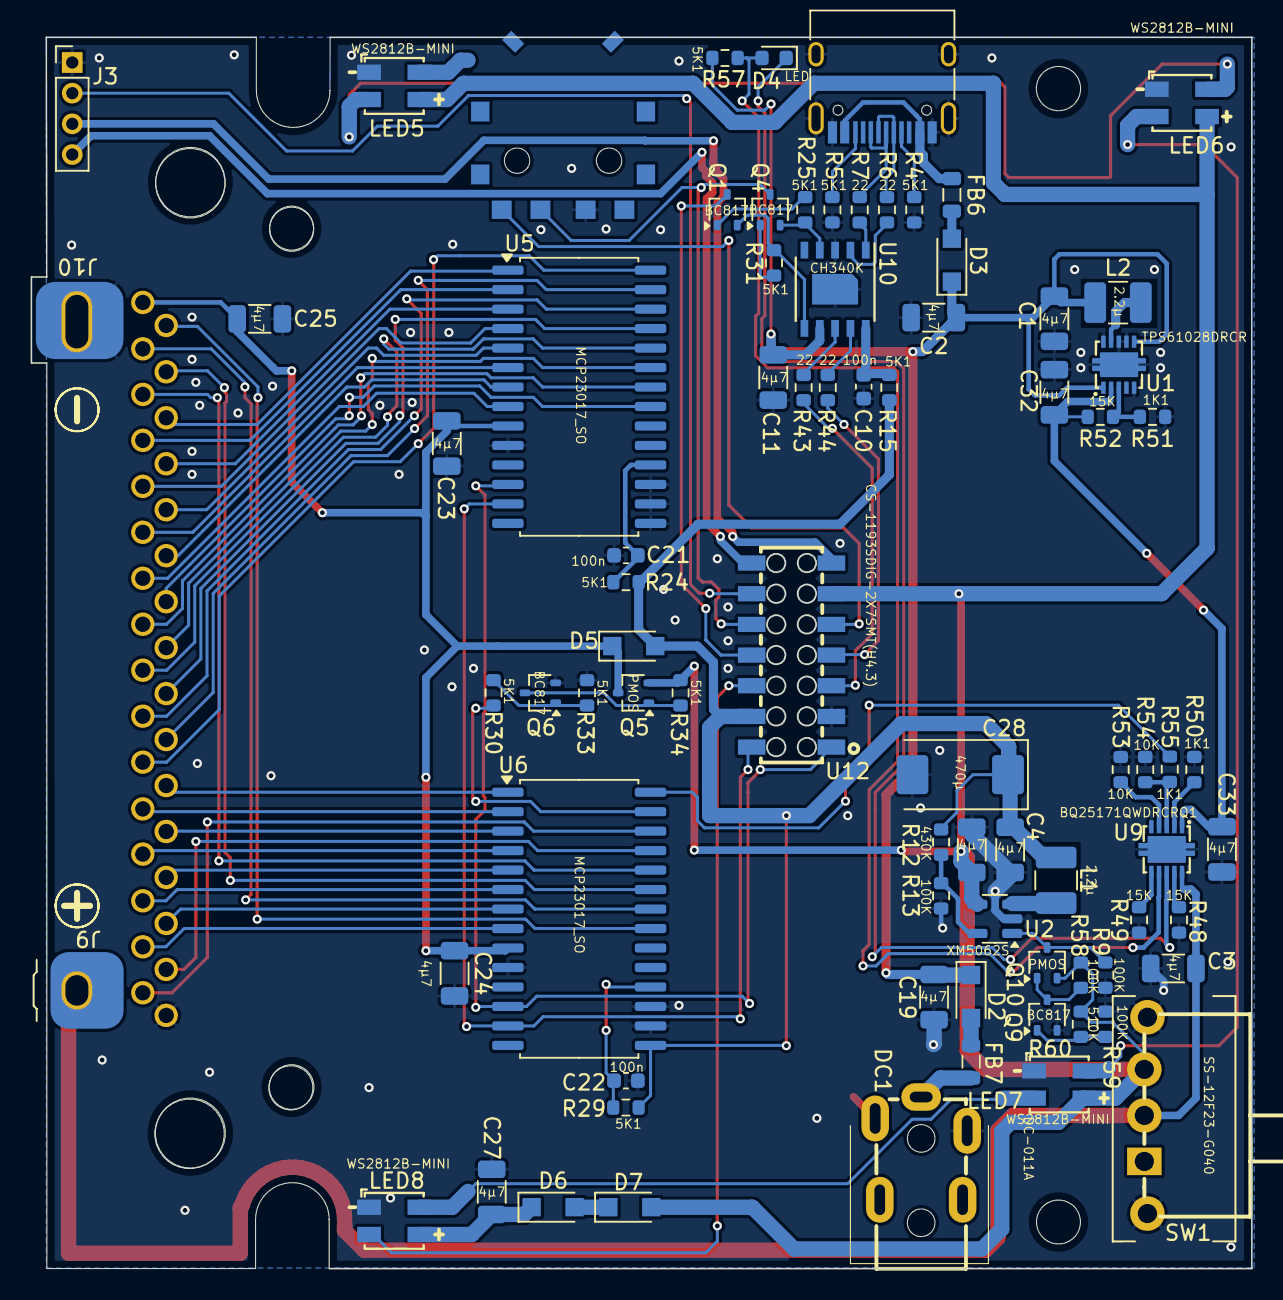
[picture p12: board ILI9341_ESP32_CARD.kicad_pcb from below]

Board: 2 copper layers, 79.6 x 80.3 mm, 83 parts (83 on the bottom side), 90 nets.

Other parts of the board:
J3: Conn_01x04_Socket; PinHeader_1x04_P2.00mm_Vertical
U12: CS-1193SDIG-2X7SMT(H4.3); PM200-2-07-S-4.3

Their connections:
+3V3: U12.4; also elsewhere on the board
/AUDIO/AUDIO_DETECT: J3.2, U12.12
/AUDIO/AUDIO_LEFT: J3.3, U12.13
/AUDIO/AUDIO_RIGHT: J3.4, U12.14
/DMG_CARD/CARD_SCL: U12.1; also elsewhere on the board
/DMG_CARD/CARD_SDA: U12.2; also elsewhere on the board
/EN: U12.8; also elsewhere on the board
/FRONT_BUTTONS/xLED: U12.6; also elsewhere on the board
/KEY_MENU: U12.9; also elsewhere on the board
/KEY_OPTION: U12.10; also elsewhere on the board
/RXD: U12.5; also elsewhere on the board
/TXD: U12.7; also elsewhere on the board
