theBrutzler/ILI9341_DMG_01/ILI9341_ESP32/ILI9341_ESP32_SOUND.kicad_pcb

## KiCad design ILI9341_ESP32/ILI9341_ESP32_SOUND.kicad_pcb (2024-07-02)

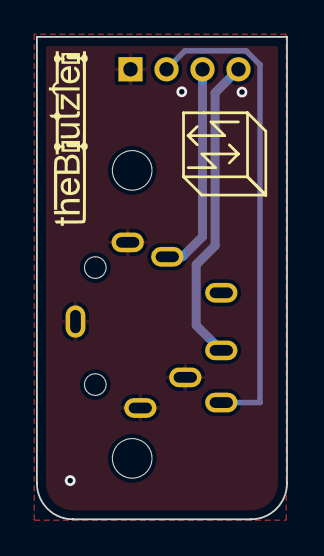
[picture p13: board ILI9341_ESP32_SOUND.kicad_pcb from above]

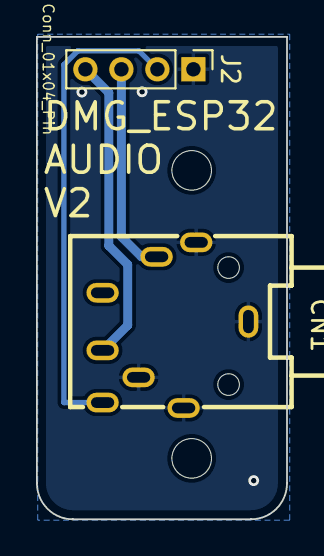
[picture p14: board ILI9341_ESP32_SOUND.kicad_pcb from below]

Board: 2 copper layers, 13.9 x 26.8 mm, 5 parts (4 on the bottom side), 4 nets.

Parts:
CN1: PJ-3043-B; AUDIO-TH_PJ-3043-B
H1, H2: MountingHole; MountingHole_2.2mm_M2
J2: Conn_01x04_Pin; PinHeader_1x04_P2.00mm_Vertical
SM3: SYM_Arrow45_Tiny; Symbol_kurzschlussblog

Connections:
unnamed: CN1.1, CN1.5, CN1.8, J2.1
unnamed: CN1.6, J2.2
unnamed: CN1.3, J2.3
unnamed: CN1.2, J2.4
