theBrutzler/ILI9341_DMG_01/ILI9341_ESP32_V1/ILI9341_ESP32_V1.kicad_pcb

## KiCad design ILI9341_ESP32_V1/ILI9341_ESP32_V1.kicad_pcb (2024-05-19, an earlier design)

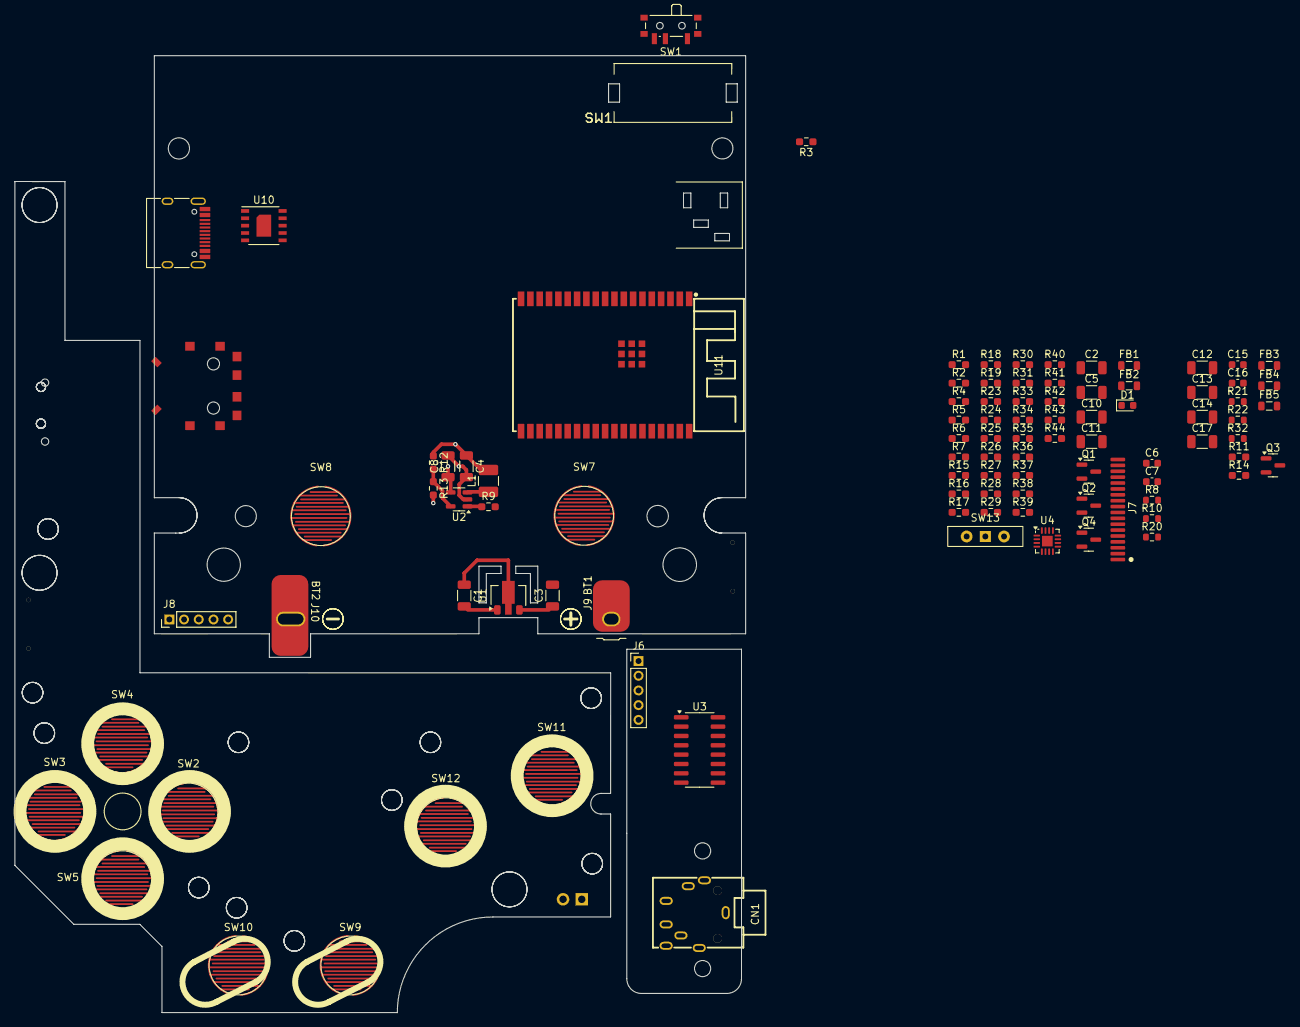
[picture p15: board ILI9341_ESP32_V1.kicad_pcb from above]

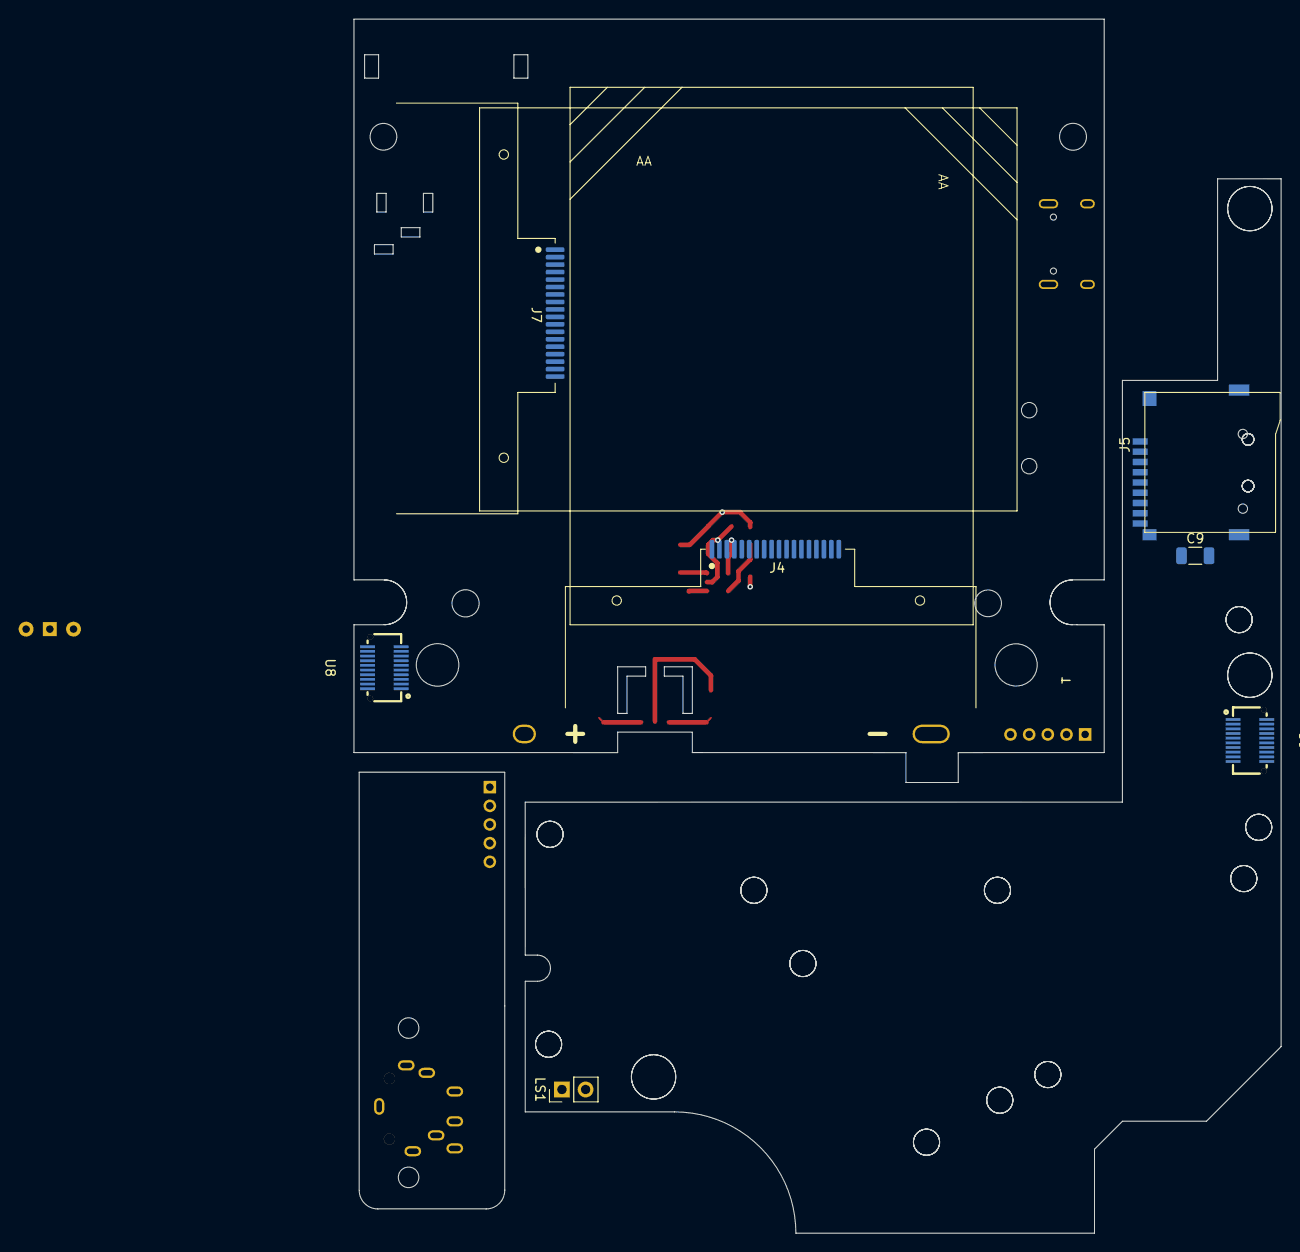
[picture p16: board ILI9341_ESP32_V1.kicad_pcb from below]

Board: 2 copper layers, 99.4 x 130.1 mm, 108 parts (7 on the bottom side), 101 nets.

Parts:
BT1: Battery_Cell; BATTERY_AA_SMD_PLUS
BT2: Battery_Cell; BATTERY_AA_SMD_MINUS
C1, C2, C3, C4, C5, C8, C9, C11, C14, C17: 4µ7; C_1206_3216Metric
C6, C7, C15, C16: 220p; C_0603_1608Metric
C10, C12, C13: 100n; C_1206_3216Metric
CN1: PJ-3043-B; AUDIO-TH_PJ-3043-B
D1: LED; LED_0603_1608Metric
FB1, FB2, FB3, FB4, FB5: FerriteBead_Small; L_0805_2012Metric
H1, H2: MountingHole; MountingHole_2.2mm_M2
J1: USB_C_Receptacle_USB2.0_16P; USB_C_Receptacle_HRO_TYPE-C-31-M-12
J4, J7, J7#2: Conn_01x18_Socket; solder connector 0.8mm 18 pin
J5: Micro_SD_Card_CD; MicroSD_Self_ bomb
J6: Conn_01x05_Pin; PinHeader_1x05_P2.00mm_Vertical
J8: Conn_01x05_Socket; PinHeader_1x05_P2.00mm_Vertical
J9: Conn_01x01_Pin; NINTENDO_PLUS
J10: Conn_01x01_Pin; NINTENDO_MINUS
L1: 2.2µ; L_1210_3225Metric_Pad1.42x2.65mm_HandSolder
LS1: Speaker; PinHeader_1x02_P2.54mm_Vertical
Q1, Q2, Q3, Q4: BC817; SOT-23
R1, R2, R11, R13, R14, R23: 100K; R_0603_1608Metric_Pad0.98x0.95mm_HandSolder
R3, R4, R5, R9, R15, R16, R17, R18, R19, R25, R31, R37, R38, R39, R40, R41, R42: 5K1; R_0603_1608Metric_Pad0.98x0.95mm_HandSolder
R6, R7, R24, R33, R34, R35, R36, R43, R44: 22; R_0603_1608Metric_Pad0.98x0.95mm_HandSolder
R8, R10, R20, R21, R22, R32: 5K1; R_0603_1608Metric
R12: 430K; R_0603_1608Metric_Pad0.98x0.95mm_HandSolder
R26: 4R7; R_0603_1608Metric_Pad0.98x0.95mm_HandSolder
R27, R28, R29, R30: 10; R_0603_1608Metric_Pad0.98x0.95mm_HandSolder
SW1: SW_DIP_x01; SW_SPDT_PCM12
SW2, SW3, SW4, SW5, SW7, SW8, SW9, SW10, SW11, SW12: SW_Push; RubberpadButton_250µ_250µ
SW13: SW_Wuerth_450301014042; SW_Slide-03_Wuerth-WS-SLTV_10x2.5x6.4_P2.54mm
U1: HE6250xx; SOT-89-3
U2: XM5062S; SOT-23-5
U3: PAM8406D; SOP-16_3.9x9.9mm_P1.27mm
U4: MAX98357AETE+T; QFN-16-1EP_3x3mm_P0.5mm_EP1.45x1.45mm
U7: 02FVS3
U8: IPCB05501F20S3V; CONN-SMD_20P-P0.50_INCP_IPCB05501F20S3V
U9: IPCB05501M20S3V; CONN-SMD_20P-P0.50_INCP_IPCB05501M20S3V
U10: CH340K; SSOP-10_3.9x4.9mm_P1.00mm_EP_3mmx2mm
U11: ESP32-WROVER-E-N8R8; WIFI-SMD_ESP32-WROVER-IE8MB

Connections:
+3V3: C4.1, C5.1, J4.9, J4.10, J7.9, J7.10, J7#2.9, J8.2, L1.2, R8.1, R12.1, R15.2, R20.2, R37.2, R38.2, R39.2, R40.2, R42.2, U4.7 (VDD), U4.8 (VDD), U8.19, U11.2 (3V3)
/D+: R7.2, U10.1 (UD+)
/D-: R6.1, U10.2 (UD-)
/DTR: Q4.2 (E), R25.1, U10.4 (~DTR)
/EN: Q1.3 (C), R39.1, U11.3 (EN)
/FRONT_BUTTONS/3V3: C9.1, J5.4 (VDD), SW2.1, SW3.1, SW4.1, SW5.1, U9.1
/FRONT_BUTTONS/A: SW11.2, U9.8
/FRONT_BUTTONS/B: SW12.2, U9.10
/FRONT_BUTTONS/DOWN: SW5.2, U9.9
/FRONT_BUTTONS/GND: C9.2, J5.6 (VSS), J5.G (SHIELD), SW9.1, SW10.1, SW11.1, SW12.1, U9.2, U9.11, U9.12, U9.17, U9.18
/FRONT_BUTTONS/LEFT: SW3.2, U9.5
/FRONT_BUTTONS/RIGHT: SW2.2, U9.3
/FRONT_BUTTONS/SD_CLK: J5.5 (CLK), U9.14
/FRONT_BUTTONS/SD_CS: J5.2 (DAT3/CD), U9.13
/FRONT_BUTTONS/SD_MISO: J5.7 (DAT0), U9.16
/FRONT_BUTTONS/SD_MOSI: J5.3 (CMD), U9.15
/FRONT_BUTTONS/SELECT: SW10.2, U9.6
/FRONT_BUTTONS/SPK+: LS1.2, U9.20
/FRONT_BUTTONS/SPK-: LS1.1, U9.19
/FRONT_BUTTONS/START: SW9.2, U9.4
/FRONT_BUTTONS/UP: SW4.2, U9.7
/I2C_CLK: R35.2, U11.26 (IO4)
/I2C_SDA: R36.2, U11.23 (IO15)
/I2S_BCK: R35.1, U4.16 (BCLK)
/I2S_DATA: R36.1, U4.1 (DIN)
/I2S_EN: J8.3, R20.1, U4.4 (SD_MODE)
/I2S_WS: U4.14 (LRCLK), U11.14 (IO12)
/KEY_A: U8.14, U11.8 (IO32)
/KEY_B: U8.12, U11.9 (IO33)
/KEY_DOWN: R18.2, U8.11
/KEY_LEFT: R17.1, R19.1, U8.15, U11.6 (IO34)
/KEY_MENU: SW7.2, U7.A, U11.16 (IO13)
/KEY_OPTION: Q4.3 (C), R40.1, SW8.2, U7.S, U11.25 (IO0)
/KEY_RIGHT: R19.2, U8.17
/KEY_SELECT: U8.16, U11.12 (IO27)
/KEY_START: R38.1, U8.18, U11.5 (SENSOR_VN)
/KEY_UP: R16.1, R18.1, U8.13, U11.7 (IO35)
/LCD_BCKL: Q2.1 (B), R23.1, U11.13 (IO14)
/LCD_CLK: J4.3, J7.3, J7#2.3, R34.2, U11.30 (IO18)
/LCD_DC: J4.4, J7.4, J7#2.4, U11.33 (IO21)
/LCD_MISO: R24.2, U11.31 (IO19)
/LCD_MOSI: J4.6, J7.6, J7#2.6, R33.2, U11.37 (IO23)
/LCD_RESET: J4.2, J7.2, J7#2.2, R37.1
/LCD_~CS: J4.5, J7.5, J7#2.5, R42.1, U11.29 (IO5)
/LED: R3.1, R41.1, U11.24 (IO2)
/RTS: Q1.2 (E), R31.1, U10.6 (~RTS)
/RXD: R43.1, U11.34 (RXD0)
/SD_CLK: R34.1, U8.8
/SD_CS: U8.7, U11.36 (IO22)
/SD_MISO: R24.1, U8.6
/SD_MOSI: R33.1, U8.5
/SOUND_LEFT: J8.4, U11.11 (IO26)
/SOUND_RIGHT: J8.5, U11.10 (IO25)
/SPK+: C6.1, FB2.2, U8.2
/SPK-: C7.2, FB1.2, U8.1
/TXD: R44.1, U11.35 (TXD0)
/VUSB: C1.1, C2.1, C11.1, J1.A4 (VBUS), J1.A9 (VBUS), J1.B4 (VBUS), J1.B9 (VBUS), U1.2 (VIN), U10.7 (VCC)
/V_BATT: C8.1, R1.1, R9.2, SW1.1, U2.4 (VIN)
/V_BAT_ADC: R1.2, R2.1, U11.4 (SENSOR_VP)
GND: BT2.2 (-), C1.2, C2.2, C3.2, C4.2, C5.2, C6.2, C7.1, C8.2, C10.2, C11.2, D1.1 (K), J1.A1 (GND), J1.A12 (GND), J1.B1 (GND), J1.B12 (GND), J1.S1 (SHIELD), J4.1, J4.8, J7.1, J7.8, J7#2.1, J7#2.8, J8.1, J10.1, Q2.2 (E), R2.2, R4.1, R5.2, R10.2, R13.2, R16.2, R17.2, R23.2, R41.2, SW7.1, SW8.1, U1.1 (GND), U2.2 (GND), U4.3 (GND), U4.11 (GND), U4.15 (GND), U4.17 (EP), U7.C, U8.3, U8.4, U8.9, U8.10, U8.20, U10.3 (GND), U10.PAD (GND), U11.1 (GND), U11.15 (GND), U11.38 (GND), U11.39 (GND)
unnamed: BT1.1 (+), C3.1, J9.1, SW1.2, U1.3 (VOUT)
unnamed: C12.2, R11.1
unnamed: C13.2, R14.1
unnamed: C15.1, CN1.2, FB5.2
unnamed: C16.2, CN1.3, FB4.2
unnamed: D1.2 (A), R3.2
unnamed: J1.A5 (CC1), R4.2
unnamed: J1.B5 (CC2), R5.1
unnamed: J1.A6 (D+), J1.B6 (D+), R7.1
unnamed: J1.A7 (D-), J1.B7 (D-), R6.2
unnamed: J4.7, J7.7, J7#2.7
unnamed: J4.11, J4.12, J4.13, J4.14, J7.11, J7.12, J7.13, J7.14, J7#2.11, J7#2.12, J7#2.13, J7#2.14, R26.2
unnamed: J4.15, J7.15, J7#2.15, R27.2
unnamed: J4.16, J7.16, J7#2.16, R28.2
unnamed: J4.17, J7.17, J7#2.17, R29.2
unnamed: J4.18, J7.18, J7#2.18, R30.2
unnamed: C14.2, C15.2, C16.1, C17.2, CN1.1, CN1.5, CN1.8, J6.1, Q3.2 (E), R22.2, U3.2 (PGNDL), U3.3 (-OUT_L), U3.11 (GND), U3.14 (-OUT_R), U3.15 (PGNDR)
unnamed: FB3.1, J6.2
unnamed: CN1.6, J6.3, Q3.1 (B)
unnamed: C12.1, J6.4
unnamed: C13.1, J6.5
unnamed: Q1.1 (B), R25.2
unnamed: Q2.3 (C), R26.1
unnamed: Q3.3 (C), R32.2, U3.12 (~SHND)
unnamed: Q4.1 (B), R31.2
unnamed: R9.1, U2.1 (EN)
unnamed: R12.2, R13.1, U2.5 (FB)
unnamed: L1.1, U2.3 (SW)
unnamed: FB4.1, U3.1 (+OUT_L)
unnamed: FB5.1, U3.16 (+OUT_R)
unnamed: R11.2, U3.7 (INL)
unnamed: R14.2, U3.10 (INR)
unnamed: R21.2, R22.1, U3.9 (MODE)
unnamed: C14.1, FB3.2, R21.1, R32.1, U3.4 (PVDDL), U3.5 (~MUTE), U3.6 (VDD), U3.13 (PVDDR)
unnamed: C17.1, U3.8 (VREF)
unnamed: R8.2, R10.1, U4.2 (GAIN_SLOT)
unnamed: FB1.1, U4.10 (OUTN)
unnamed: FB2.1, U4.9 (OUTP)
unnamed: R44.2, U10.9 (RXD)
unnamed: R43.2, U10.8 (TXD)
unnamed: C10.1, R15.1, U10.10 (V3)
