theBrutzler/ILI9341_DMG_01/(commit log)

2024-05-13 Initial Upload
    Not finished yet
    [ILI9341_ESP32_V1.kicad_pcb, ILI9341_ESP32_V1.kicad_sch]
2024-05-16 Add new connection (inter PCB)
    build up new concept to fit in original gameboy case :) hope so
    sound tested on prototyp wirering
    [FRONT_BUTTONS.kicad_sch, ILI9341_ESP32_V1.kicad_pcb, ILI9341_ESP32_V1.kicad_sch]
2024-05-19 Update ESP from S3 to WROVER
    Changed ESP to be compatible to odroid-go
    [AUDIO.kicad_sch, FRONT_BUTTONS.kicad_sch, ILI9341_ESP32_V1.kicad_pcb, ILI9341_ESP32_V1.kicad_sch]
2024-05-28 update cardridge grabber funktion
    [AUDIO.kicad_sch, FRONT_BUTTONS.kicad_sch, ILI9341_ESP32_V1.kicad_sch, bom.csv, designators.csv, positions.csv, untitled.kicad_sch]
2024-06-01 update routing and put display on front pcb
    [FRONT_BUTTONS.kicad_sch, ILI9341_ESP32_V1.kicad_sch, bom.csv, designators.csv, positions.csv]
2024-06-01 add schematic pdf
2024-06-18 update to funktion version without 5khz noise on audio amp
    [AUDIO.kicad_sch, FRONT_BUTTONS.kicad_sch, ILI9341_ESP32.kicad_sch, ILI9341_ESP32_V1.kicad_sch, JLC_PARTLIST.csv, bom.csv, designators.csv, positions.csv]
2024-06-18 zwischenstand v2
    [FRONT_BUTTONS.kicad_sch, ILI9341_ESP32.kicad_sch]
2024-06-20 Update PCB and add RGB
    [FRONT_BUTTONS.kicad_sch, ILI9341_ESP32.kicad_sch, untitled.kicad_sch]
2024-06-25 zwischenstand battery pcb finished
2024-06-27 update nimh charger and battery protection
    [AUDIO.kicad_sch, FRONT_BUTTONS.kicad_sch, ILI9341_ESP32.kicad_sch, bom.csv, designators.csv, positions.csv]
2024-07-02 ordered Version
    [AUDIO.kicad_sch, FRONT_BUTTONS.kicad_sch, ILI9341_ESP32 - Kopie.kicad_sch, ILI9341_ESP32.kicad_sch, ILI9341_ESP32_CARD.kicad_pcb, ILI9341_ESP32_MAIN.kicad_pcb, ILI9341_ESP32_PANEL.kicad_pcb, ILI9341_ESP32_SOUND.kicad_pcb]
2024-07-30 upload new untested version
    the boosconverter should work now :)
    [FRONT_BUTTONS.kicad_sch, ILI9341_ESP32.kicad_sch]
